eSpark-Backup/oliverstanton-watermonitor/Design-Files/GTV3.5_Board/Deliverables/Renderings/Isometric.png

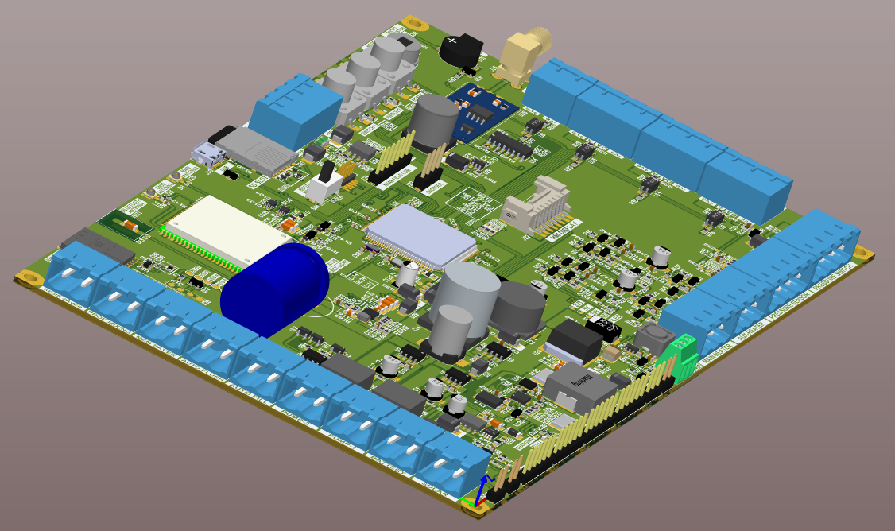
Design-Files/GTV3.5_Board/Deliverables/Renderings/Isometric.png
