eSpark-Backup/oliverstanton-watermonitor/README.md

# OliverStanton-WaterMonitor
To reverse engineer the existing product of the client and generate all the deliverables

 ## Firmware Upload Document
[GrippaT-FirmwareUpload](https://docs.google.com/document/d/1irUmZNVhjHcHC-Ms7zZixrjyYP5oRqWBCGlWPWXGvVM/edit#heading=h.wwlx76fb44li)
