eSpark-Backup/oliverstanton-watermonitor/Design-Files/GTV3.5_Board/GTV3.5_Board.html

Reporting Options

# File in Newer Format

Date | : | 05/03/2024
Time | : | 18:57:56
Project name | : | D:\Github\OliverStanton-WaterMonitor\Design-Files\GTV3.4_Board\GTV3.4_Board.PrjPcb
Schematic documents | : | SD-Card-Sheet.SchDoc

Version | Warning
22.3.0 | Custom diff pair suffixes are not supported in this version.

These files were generated in a later version of Altium Designer. Be aware that some data may have been added through functionality not available in your current version and will therefore not be available to you.
