eSpark-Backup/oliverstanton-watermonitor/Documents/Client-Files/S3 User Instructions/@1 S3 Overview - Description V1.0 .pdf

S3 Pump Controller | Overview | S3

Thank you for buying an S3 Static RO Controller. This is an advanced pump controller solution for your system and it should give you complete control over your water production. Follow this manual carefully. It explains in detail how to connect and operate this pump controller. Most connections are shown on the System Diagram, however further details
are provided throughout the rest of this manual. Complete ALL wiring connections BEFORE connecting the unit to the mains supply. Ensure the controller, sensors and cables are firmly fixed in place before using your controller.
The controller controls the filling side of your water tank (inlet and pure water production). The controller has a number of other advanced features to increase ease of use and report on the operational status of your system.
The controller opens the solenoid valve to fill the water tank up to the level of the high level float switch. This is a one time operation until the tank is full. The controller will automatically flush your RO membrane on a regular basis to keep it at optimum performance and to increase its service life.
The controller can be configured to stop filling if the TDS is too high, either after the RO membrane (due to an RO failure) or after the DI vessel (if resin is spent). It will also shutdown the fill if the mains water pressure is too low.
The controller has a flowmeter to measure the amount of water used and so can also indicate the filter life.
The controller also incorporates a pressure sensor which allows the controller to report on the state of your carbon and sediment filters. The addition of a pressure sensor also allows the controller to shut down your pump in the event of a mains water failure.

### Overview

1
