eSpark-Backup/oliverstanton-watermonitor/Documents/Client-Files/V3 User Instructions/@1 V3 Overview - Description V1.0 .pdf

V3 Pump Controller | Overview | V3

Thank you for buying a V3 Pump Controller. This is an advanced pump controller solution for your system and it should give you complete control over both the water production and water delivery.
Follow this manual carefully. It explains in detail how to connect and operate this pump controller. Most connections are shown on the System Diagram, however further details are provided throughout the rest of this manual. Complete ALL wiring connections BEFORE fitting the main fuse. Ensure the controller, sensors and cables are firmly fixed in place before using your controller.
NOTE: It is recommended that power wires from battery to controller (RED + BLACK)
and power wires to the pump (BROWN + BLUE) are run through flexible conduit.
The controller controls both the filling side of your water tank (inlet and pure water production) and the delivery side (outlet to the reel and pole). The controller also has a number of other advanced features.
The controller opens the solenoid valve to fill the water tank up to the level of the high level float switch. This a one time operation until the tank is full. The controller will automatically flush your RO membrane on a regular basis to keep it at optimum performance and to increase its service life.
The controller can be configured to stop filling if the TDS is too high, either after the RO membrane (due to an RO failure) or after the DI vessel (if resin is spent). It will also shutdown the fill if the mains water pressure is too low.
The controller has a flowmeter to measure the amount of water used and so can also indicate the filter life.
On the delivery side the controller can control the pump flowrate. (It can also be calibrated to shutdown when the pump flow encounters a dead end or stop).
The controller has a built in split charger which will charge your leisure battery as soon as the vehicle alternator starts.
The controller can also control a diesel heater (such as a Webasto) if a hot water system is fitted. The controller allows the heater to be turned on and off. It provides a frost stat (which can be disabled in summer) and also allows the user to set the frost stat activation temperature and the rate of water recirculation.
Finally the controller can be operated by radio control. With the radio fob the user can turn the pump on or off. They can also adjust the flowrate with the up or down button.

### Overview

1
