eSpark-Backup/oliverstanton-watermonitor/Design-Files/Fob_TransmitterV2.00/Deliverables/Renderings/3D_Bottom_View.PNG

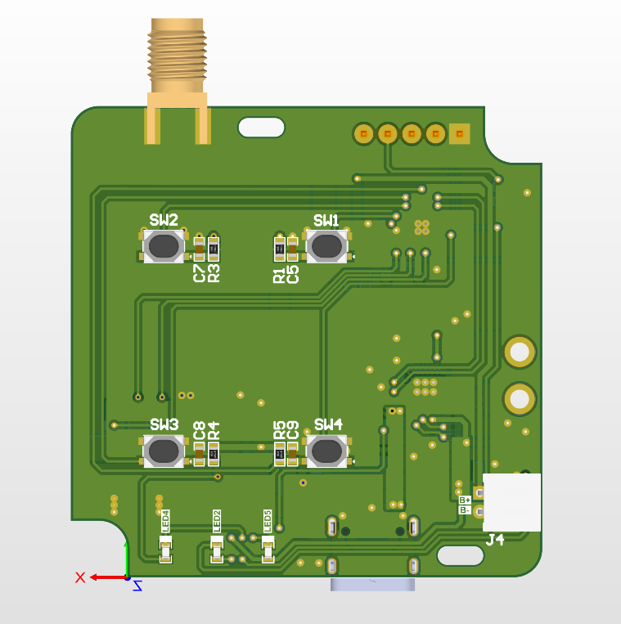
Design-Files/Fob_TransmitterV2.00/Deliverables/Renderings/3D_Bottom_View.PNG
