eSpark-Backup/oliverstanton-watermonitor/Documents/Developer-Files/Parts List.xlsx

Oliver Stanton - Parts List
S.No | Component Type | Component Name | Manufacturer Part Number | Supplier Link | Remarks
1 | IC | Main Controller | STM32F072R8T6 | LCSC (https://www.lcsc.com/product-detail/ST-Microelectronics_STMicroelectronics-STM32F072RBT6_C46046.html)
2
3
4
