eSpark-Backup/oliverstanton-watermonitor/Design-Files/GTV3.5_Board/BOM/Client-BOM-GTV3.4_Board.xlsx

# | Item Type | Designator | Description | Footprint | Manufacturer Part Number | Manufacturer | Value | Quantity | Remarks
1 | Antenna | ANT1 | 5.05dBi Chip antenna Linear 160MHz 2.45GHz 1W 1206 Antennas ROHS | Custom | ANT3216LL00R2400A | YAGEO | - | 1
2 | Capacitor | C1, C4, C17, C21, C23, C24, C43, C58, C61, C63, C65, C67 | CAP ALUM 10uF 25V SMD | Custom | RVT1E100M0405 | ROQANG | 10uF | 12
3 | Capacitor | C2 | CAP CER 0.1UF 100V X7R 1206 | Cap-1206 | CC1206KKX7R0BB104 | Yageo | 0.1uF | 1
4 | Capacitor | C3, C40, C45, C59 | CAP CER 1UF 25V X5R 0603 | Cap0603 | CC0603KRX5R8BB105 | Yageo | 1uF | 4
5 | Capacitor | C5, C88, C90, C97, C102 | CAP CER 0.1UF 100V X5R 0402 | Cap-0402 | GRM155R62A104KE14D | Murata | 0.1uf | 5
6 | Capacitor | C6, C18, C22, C25, C26, C37, C38, C39, C44, C46, C47, C48, C49, C51, C52, C55, C60, C62, C64, C66, C68, C69, C76, C82, C87 | CAP CER 0.1UF 50V Y5V 0603 | Cap0603 | CC0603ZRY5V9BB104 | Yageo | 0.1uF | 25
7 | Capacitor | C7, C15, C71 | CAP CER 1UF 16V X5R 0402 | Cap-0402 | CC0402KRX5R7BB105 | Yageo | 1uF | 3
8 | Capacitor | C8, C28 | CAP CER, X5R, 10 V, 1206 [3216 Metric] | Cap-1206 | C3216X5R1A107M160AC | TDK | 100uF | 2
9 | Capacitor | C9 | CAP ALUM 100UF 20% 25V SMD | Custom | UWX1E101MCL1GB | Nichicon | 100uF | 1
10 | Capacitor | C10, C27, C101, C103, C104, C108 | CAP CER 0.1UF 25V X6S 0201 | CAP-0201 | GRM033C81E104KE14D | Murata | 0.1uF | 6
11 | Capacitor | C11, C19 | CAP CER 1000PF 25V C0G 0402 | Cap-0402 | C1005C0G1E102JT000F | TDK | 1nF | 2
12 | Capacitor | C12, C29, C30, C31, C32, C33, C36, C73, C92, C93, C95, C109, C110, C111, C113, C114 | CAP CER 0.1UF 50V X5R 0402 | Cap-0402 | C1005X5R1H104K050BB | TDK | 0.1uF | 16
13 | Capacitor | C13 | CAP CER 10PF 50V C0G/NP0 0402 | Cap-0402 | GRM1555C1H100JA01D | Murata | 10pF | 1
14 | Capacitor | C14, C96 | CAP CER 33PF 25V C0G/NP0 0402 | Cap-0402 | GRM1555C1E330JA01D | Murata | 33pF | 2
15 | Capacitor | C16 | 470uF ±20% 50V 12.5mm 13.5mm 1000hrs 105℃ -40℃~+105℃ SMD,12.5x13.5mm Aluminum Electrolytic Capacitors - SMD RoHS | Custom | VT1H471MI135000CE0 | Changzhou Huawei Elec | 470uF | 1
16 | Capacitor | C20 | CAP CER 470pF 10% X7R 50V 0603 SMD | Cap0603 | CC0603KRX7R9BB471 | Yageo | 470pF | 1
17 | Capacitor | C34, C35 | CAP 30pF NP0 0603 50 V ±5 % SMD | Cap0603 | CC0603JRNPO9BN300 | Yageo | 30pF | 2
18 | Capacitor | C41, C80, C81, C83, C86 | CAP CER 1UF 50V X5R 0402 | Cap0402 | UMK105CBJ105MV-F | Taiyo Yuden | 1uF | 5
19 | Capacitor | C42, C79, C117 | CAP CER 1UF 25V X5R 0603 | Cap-0603 | CC0603KRX5R8BB105 | Yageo | 1uF | 3
20 | Capacitor | C50, C54, C74 | CAP CER 0.1UF 16V X5R 0402 | Cap-0402 | CC0402KRX5R7BB104 | Yageo | 100nF | 3
21 | Capacitor | C53, C78 | CAP CER 20PF 50V C0G/NPO 0603 | Cap0603 | CC0603JRNPO9BN200 | Yageo | 20pF | 2
22 | Capacitor | C56 | CAP CER 0.047UF 100V X7R 1206 | Cap-1206 | CC1206JRX7R0BB473 | Yageo | 0.047uF | 1
23 | Capacitor | C57 | CAP CER 10UF 35V X5R 0603 | Cap0603 | GRM188R6YA106MA73D | Murata | 10uF | 1
24 | Capacitor | C70 | CAP ALUM 1000UF 20% 10V SMD | Custom | UUD1A102MNL1GS | Nichicon | 1000uF | 1
25 | Capacitor | C72 | CAP CER 10UF 16V X5R 0603 | Cap-0603 | CC0603KRX5R7BB106 | Yageo | 10uF | 1
26 | Capacitor | C75 | CAP CER 0.1UF 50V X7R 0402 | Cap-0402 | CL05B104KB54PNC | Samsung | 0.1uF | 1
27 | Capacitor | C77 | CAP CER 10UF 25V X5R 0603 | Cap-0603 | C1608X5R1E106M080AC | TDK | 10uF | 1
28 | Capacitor | C84, C85, C116, C118, C119 | CAP CER 22UF 35V X5R 0805 | Cap-0805 | C2012X5R1V226MT000E | TDK Corporation | 22uF | 5
29 | Capacitor | C89 | CAP TANT 330UF 20% 16V 2917 | Case-E | TAJE337M016RNJ | Kyocera AVX | 330uF | 1
30 | Capacitor | C91 | CAP TANT 100UF 20% 10V 1411 | Case-B | TAJB107M010RNJ | Kyocera AVX | 100uF | 1
31 | Capacitor | C94 | CAP CER 2.2UF 25V X5R 0402 | Cap-0402 | GRM155R61E225KE11D | Murata | 2.2uf | 1
32 | Capacitor | C98, C99, C100 | CAP CER 22PF 50V C0G/NP0 0201 | CAP-0201 | GRM0335C1H220JA01D | Murata | 22pF | 3
33 | Capacitor | C105, C106 | CAP CER 0.1UF 25V X6S 0201 | CAP-0201 | GRM033C81E104KE14D | Murata | 0.1uF | 2
34 | Capacitor | C107, C112 | CAP CER 10UF 10V X5R 0402 | Cap-0402 | CC0402MRX5R6BB106 | Yageo | 10uF | 2
35 | Supercapacitor | C115 | CAP 25F -10% +30% 2.7V T/H | Custom | SCCU25B256SRB | Kyocera AVX | 25F | 1
36 | Capacitor | C120, C121 | CAP CER 47UF 25V X5R 1206 | Cap-1206 | C3216X5R1E476M160AC | TDK | 47uF | 2
37 | Capacitor | C122 | CAP CER 0.47UF 50V X5R 0603 | Cap-0603 | CC0603KRX5R9BB474 | Yageo | 0.47uF | 1
38 | Capacitor | C123 | CAP CER 2200PF 50V X7R 0603 | Cap-0603 | CC0603KRX7R9BB222 | Yageo | 2.2nF | 1
39 | Capacitor | C124, C126 | CAP ALUM 10uF 25V SMD | Custom | RVT1E100M0405 | ROQANG | 10uF | 2
40 | Capacitor | C125, C127 | CAP CER 0.1UF 50V Y5V 0603 | Cap-0603 | CC0603ZRY5V9BB104 | Yageo | 0.1uF | 2
41 | Capacitor | C128, C129 | CAP CER 22UF 10V X5R 0603 | Cap-0603 | CC0603MRX5R6BB226 | Yageo | 22uF | 2
42 | Diode | D1, D28, D29 | 40V 500mV@2A 2A SMA(DO-214AC) Schottky Barrier Diodes (SBD) ROHS | SMA | SS24A | Yangzhou, Guangdong Hottech | - | 3
43 | Zener diode | D2, D30 | DIODE ZENER 16V 1.5W SMA | SMA | 1SMA5930BT3G | ON Semiconductor, onsemi | - | 2
44 | Diode | D3 | 800uA 43.5A 9.2V 6.4V 5V 7V Bi-Directional SMA TVS ROHS | Custom | SMAJ5.0CA | Shandong Jingdao Microelectronics | - | 1
45 | Diode | D4, D18 | 16A 20V 7V 5V@Max Unidirectional SOT-23 TVS ROHS | Sot-23 | ESD5302F-3/TR | WILLSEMI | - | 2
46 | Diode | D5, D8 | SMB(DO-214AA) TVS ROHS | SMB_ | SMBJ26CA | MSKSEMI | - | 2
47 | Diode | D6 | 1uA 5.3A 113V 77.8V 70V 86V Unidirectional SMB(DO-214AA) TVS ROHS | SMB | SMBJ70A/TR13 | Brightking | - | 1
48 | Diode | D7 | SCHOTTKY DIODE SMB 100V 5A | SS510B | SS510B | MDD | - | 1
49 | ESD Diode | D9, D13 | 0402 ESD Protection Devices ROHS | Custom | TPESD0402G03V | TECH PUBLIC | - | 2
50 | Protection Device | D10, D16, D19 | SOD-523 ESD Protection Devices ROHS | SOD-523 | LESD5D5.0CT1G | UMW | - | 3
51 | Diode | D11 | DIODE SCHOTTKY 60V 5A SMA | SMA | SS56 | MDD | - | 1
52 | Diode | D12 | TVS DIODE 5VWM 9.2VC SMA | SMA | SMAJ5.0CA | FTR | - | 1
53 | Diode | D14 | DIODE SCHOTTKY 40V 10A POWERDI5 | PowerDI™ 5 | PDS1040-13 | Diodes | - | 1
54 | Diode | D15 | DIODE SCHOTTKY 40V 380MA SOD523 | SOD-523 | ZLLS350TA | Diodes Zetex | - | 1
55 | Diode | D17 | TVS DIODE 5VWM 6.3VC DSN0603-2 | DSN0603-2 | PESD5V0H1BSFYL | Nexperia | - | 1
56 | Protection Device | D20, D21, D22, D23, D24 | 5V 10V 3.3V Bi-Directional SOD-882 ESD Protection Devices ROHS | SOD-882 | LESD8D3.3CAT5G | LRC | - | 5
57 | Diode | D25, D26 | DIODE GEN PURP 100V 300MA SOD123 | SOD-123 | 1N4148W-7-F | Diodes | - | 2
58 | Diode | D27 | 35A@8/20us 15V 4.5V@Max Unidirectional DFN1006 TVS ROHS | DFN1006-2L_ | ESD5651N-2/TR | WILLSEMI(Will Semicon) | - | 1
59 | Diode | D31 | 1A Single 1kV 1.1V@1A SMA(DO-214AC) Diodes - General Purpose ROHS | SMA(DO-214AC) | 1N4007 | TWGMC | - | 1
60 | Fuse | F1 | 6V 500mA 40A 1A 0603 Resettable Fuses ROHS | Fuse-0603 | SMD0603-050 | TECHFUSE | - | 1
61 | Fuse | F2, F3 | 9V 200mA 100A 500mA 0805 Resettable Fuses ROHS | Fuse-0805 | SMD0805P020TF | RUILON | - | 2
62 | Ferrite Bead | FB1 | FERRITE BEAD 220 OHM 0805 1LN | Ind-0805 | MPZ2012S221ATD25 | TDK | 100MHz | 1
63 | Jtag Header | J1 | CONN HEADER SMD 10POS 1.27MM | Custom | 20021121-00010C4LF | Amphenol FCI | - | 1
64 | Terminal Block | J2, J3, J4, J5, J6, J7, J8, J9, J11, J21 | TERMINAL BLOCK, PLUGGABLE, 5.08, | Custom | TBP01R1-508-02BE | CUI Devices | - | 10
65 | Terminal Block | J10, J12, J13, J16, J17 | TERMINAL BLOCK, PLUGGABLE, 5.08, | Custom | TBP01R1-508-03BE | CUI Devices | - | 5
66 | Terminal Block | J14, J20, J29 | TERMINAL BLOCK, PLUGGABLE, 5.08, | Custom | TBP01R1-508-04BE | CUI Devices | - | 3
67 | SMA | J15 | 1 Inner bore SMA Board Edge Bend -55℃~+155℃ 50Ω Plugin RF Connectors / Coaxial Connectors ROHS | Custom | HJ-SMA508 | HJ Tech | - | 1
68 | Terminal | J18 | 1x3P -40℃~+105℃ 8A 130V 18~26 Direct Insert 2.54mm 0.5~1 1 3 Plugin,P=2.54mm Screw Terminal Blocks ROHS | Custom | DB125-2.54-3P-GN-S | DORABO | - | 1
69 | USB Connector | J19 | CONN RCPT USB2.0 MICRO B SMD R/A | Custom | 10118194-0001LF | Amphenol FCI | - | 1
70 | Wire To Wire Connector | J22 | 1x8P PH 1 2mm 8 Brass SMD,P=2mm Wire To Board / Wire To Wire Connector ROHS | Custom | A2008WR-S-8P | CJT | - | 1
71 | Header | J23 | Straight 2.54mm Black Brass 1x4P Plugin,P=2.54mm Pin Headers ROHS | HDR1X4_ | B-2100S04P-A110 | Ckmtw | - | 1
72 | Male Header | J24 | Straight Square Pins 2.5mm 7P 6mm -40℃~+105℃ 3mm 2.54mm Plugin Black Brass 1x7P Plugin,P=2.54mm Pin Headers ROHS | HDR1X7 | PZ254V-11-07P | XFCN | - | 1
73 | Connector | J25, J26 | CONN U.FL RCPT STR 50 OHM SMD | Custom | U.FL-R-SMT-1(80) | Hirose | - | 2
74 | SIM Card Connectors | J27 | Copper Alloy Self bomb Gold plating 1.25mm Deck -40℃~+85℃ 260℃ NanoSIM SMD SIM Card Connectors ROHS | Custom | XKNANO-113 | XKB Connectivity | - | 1
75 | Pogo Connector | J28 | Pogo Pad 2.5mm 4 Pin | Custom | POGO Connector 4 Pin | - | - | 1
76 | SD Card Connector | J30 | CONN MICRO SD CARD PUSH-PUSH R/A | Custom | DM3BT-DSF-PEJS | Hirose | - | 1
77 | Inductor | L1 | IND SMD 10uH 500mA 0805 | Ind-0805 | MGFL2012F100MT-LF | microgate | 10uH | 1
78 | Inductor | L2 | Inductor Power Shielded Wirewound 220uH 20% 1KHz Ferrite 1.3A 310mOhm DCR Blister T/R | Custom | SLF12575T-221M1R3-PF | TDK | 220uH | 1
79 | Inductor | L3 | 3.7A 4.7uH ±20% SMD,7.3x7.3mm Power Inductors ROHS | Custom | YPRH0704-4R7M | YJYCOIN | 4.7uH | 1
80 | Inductor | L5 | IND SMD 3.3UH 20A | Custom | SRP1245CC-3R3M | Bourns | 3.3uH | 1
81 | Inductor | L6 | Ind Chip Wirewound 68nH 5% 200MHz 37Q-Factor Ceramic 600mA 0603 | IND-0603 (1608 Metric) | 0603CS-68NXJLW | Coilcraft | 68nH | 1
82 | Inductor | L7 | FIXED IND 470NH 4.9A 0.023OHM SM | Inductor 1008 | DFE252012F-R47M=P2 | Murata | 470nH | 1
83 | LED | LED1, LED2, LED3, LED4, LED5, LED6, LED7 | LED RED CLEAR CHIP SMD | LED 0402 | XZMDK68W-2 | SunLED | - | 7
84 | LED | LED8 | SENSOR PHOTO 630NM 2SMD | Custom | ALS-PT19-315C/L177/TR8 | Everlight | - | 1
85 | LED | LED9 | RED LED 0603 Light Emitting Diodes | LED-0603 | NCD0603R3 | Foshan NationStar Optoelectronics | - | 1
86 | LED | LED10 | Green 520~535nm 0402 Light Emitting Diodes (LED) RoHS | LED-0402 | 16-213/GHC-YR1S1/3T | Everlight Elec | - | 1
87 | LED | LED11, LED13 | Red 632nm LED Indication - Discrete 2.05V 0603 (1608 Metric) | LED-0603 | 19-21/R7C-AK1L2BY/3T | Everlight Elec | - | 2
88 | LED | LED12 | Yellow-Green 572nm LED Indication - Discrete 2.05V 0603 (1608 Metric) | LED-0603 | 19-21/G6C-FM1N2B/3T | Everlight Elec | - | 1
89 | Buzzer | LS1 | NO 2700Hz 85dB @ 3V, 10cm 3V Φ9mm SMD,9x3.2mm Buzzers RoHS | Custom | YS-SBZ9032C03R16 | Fengming | - | 1
90 | Test Point | ~~P1, P7, P9, P10, P11, P16~~ | ~~Test Point ON~~ | ~~Custom~~ | ~~Test-point - 0.5mm~~ | ~~-~~ | ~~-~~ | ~~6~~ | ~~Do NOT PLACE~~
91 | TEST POINT | ~~P2, P12, P13, P14, P15~~ | ~~Test Point ON~~ | ~~Custom~~ | ~~TEST POINT~~ | ~~-~~ | ~~-~~ | ~~5~~ | ~~Do NOT PLACE~~
92 | Connector | P3, P4, P5, P8 | CONN HEADER VERT 6POS 2.54MM | HDR1X6 | 61300611121 | Wurth Electronics | - | 4
93 | Connector | P6 | CONN HEADER VERT 3POS 2.54MM | HDR1X3 | 61300311121 | Wurth Electronics | - | 1
94 | Connector | P19, P27, P28 | CONN HEADER VERT 2POS 2.54MM | HDR1X2 | 61300211121 | Wurth Electronics | - | 3
95 | Mosfet | Q1, Q2, Q3, Q4, Q8 | Single N-Channel, 20V, 4.7A, Power MOSFET | sot-23 | WNM2016A-3/TR | WILLSEMI | - | 5
96 | Mosfet | Q5, Q6 | MOSFET N-CH 55V 110A D2PAK | D2Pak. | IRF3205STRLPBF | Infineon Technologies | - | 2
97 | Mosfet | Q7, Q21 | MOSFET P-CH 20V 3.7A SOT23 | SOT-23 | IRLML6402TRPBF | International Rectifier | - | 2
98 | Transistor | Q9, Q10, Q11, Q12, Q13, Q14, Q15, Q16, Q29, Q30 | NPN Ic=100mA Vceo=45V hfe=200~450 P=250mW | SOT-23 | BC847B,215 | Nexperia | - | 10
99 | Transistor | Q17, Q24 | PNP Ic=-100mA Vceo=-45V hfe=420~800 P=250mW | SOT-23 | BC857C,215 | Nexperia | - | 2
100 | Transistor | Q18, Q19, Q31, Q38 | TRANS NPN 160V 0.6A SOT-23 | SOT-23 | MMBT5551LT1G | ON Semiconductor | - | 4
101 | Mosfet | Q20 | 60V 80A 2.5W 7mΩ@10V,20A 3V@250μA N Channel SOP-8_150mil MOSFETs ROHS | Custom | RU6085H | Shenzhen | - | 1
102 | Mosfet | Q22, Q23, Q33, Q40, Q43 | TRANS NPN 40V 0.6A SMD SOT23-3 | SOT-23 | MMBT2222A-7-F | Diodes | - | 5
103 | Mosfet | Q25 | MOSFET N-CH 130V 1A SOT23 | SOT23-3 | DMN13H750S-7 | Diodes | - | 1
104 | Mosfet | Q26 | N-CHANNEL 20-V (D-S) MOSFET | Sot-23 | SI2302CDS | TECH PUBLIC | - | 1
105 | Mosfet | Q32 | 30V 4.1A 60mΩ@10V,4.1A 350mW 3V@250uA P Channel SOT-23 MOSFETs ROHS | SOT-23 | AO3407 | Guangdong Hottech | - | 1
106 | Mosfet | Q39 | MOSFET N-CH 60V 115MA SOT23-3 | SOT23-3 | 2N7002-7-F | Diodes | - | 1
107 | Resistor | R1 | Res Thick Film 0603 3.6K Ohm 1% 1/10W ±100ppm/°C Molded SMD Paper T/R | RES-0603 | AC0603FR-073K6L | Yageo | 3.6K | 1
108 | Resistor | R2 | RES 1.2K OHM 1% 1/10W 0603 | RES-0603 | RC0603FR-071K2L | Yageo | 1.2k | 1
109 | Resistor | R3 | ±1% 1/10W Thick Film Resistors 75V ±600ppm/℃ -55℃~+155℃ 0.33Ω 0603 Chip Resistor - Surface Mount ROHS | RES-0603 | RTT03R330FTP | RALEC | 0.33R | 1
110 | Resistor | R4, R6, R9, R27, R68, R69, R70, R72, R82, R101, R102, R110, R114, R126, R128, R168 | RES SMD 10K Ohm 1% 1/10W 0603 | Res-0603 | RC0603FR-0710KL | Yageo | 10K | 16
111 | Resistor | R5, R8 | RES SMD 4.7K OHM 0.1% 1/10W 0603 | Res-0603 | AT0603BRD074K7L | Yageo | 4.7K | 2
112 | Resistor | R7, R10 | RES SMD 6.8K OHM 0.1% 1/10W 0603 | Res-0603 | RT0603BRE076K8L | Yageo | 6.8K | 2
113 | Resistor | R11 | 100mW Thick Film Resistors 75V ±1% ±100ppm/℃ -55℃~+155℃ 2.21MΩ 0603 Chip Resistor - Surface Mount ROHS | RES-0603 | 0603WAF2214T5E | UNI-ROYAL | 2.21M | 1
114 | Resistor | R12, R73, R74, R134, R170 | RES 10K OHM 1% 1/16W 0402 | Res-0402 | RC0402FR-0710KL | Yageo | 10K | 5
115 | Resistor | R13 | RES 2.7K OHM 1% 1/16W 0402 | Res-0402 | RC0402FR-072K7L | Yageo | 2.7K | 1
116 | Resistor | R14, R15, R17 | RES SMD 680 OHM 1% 1/10W 0603 | RES-0603 | RC0603FR-07680RL | Yageo | 680R | 3
117 | Resistor | R16 | RES SMD 2.2K OHM 1% 1/16W 0402 | Res-0402 | RC0402FR-072K2L | Yageo | 2.2K | 1
118 | Resistor | R18, R19, R22, R37, R39, R78, R80, R111, R115 | RES SMD 2.2K OHM 1% 1/10W 0603, RES 2.2K OHM 1% 1/10W 0603 | RES-0603 | RC0603FR-072K2L | Yageo Phycomp, Yageo | 2.2K | 9
119 | Resistor | R20, R21, R66 | RES SMD 10K OHM 5% 1/10W 0603 | RES-0603 | AC0603JR-0710KL | Yageo | 10K | 3
120 | Resistor | R23, R35, R36, R38, R76, R77, R79 | RES SMD 3.3K OHM 1% 1/10W 0603 | RES-0603 | RC0603FR-073K3L | Yageo Phycomp | 3.3K | 7
121 | Resistor | R24, R25 | RES SMD 47OHM 0.1W 0603 | RES-0603 | RC0603FR-0747RL | Yageo | 47R | 2
122 | Resistor | R26, R34, R40, R41, R50, R51, R67, R71, R75, R85 | RES SMD 1K OHM 1% 1/10W 0603 | RES-0603 | RC0603FR-071KL | Yageo | 1K | 10
123 | Resistor | R28, R33, R42, R43, R44, R45, R46, R47, R48, R49, R52, R53, R56, R62, R86, R88 | RES SMD 4.7K OHM 1% 1/10W 0603 | RES-0603 | RC0603FR-074K7L | Yageo | 4.7K | 16
124 | Resistor | R29, R107 | RES SMD 1K 0.1W 0603 75 V, Thick Film | Res-0603 | RC0603JR-071KL | Yageo | 1K | 2
125 | Resistor | R30 | RES SMD 20K OHM 0.1% 1/10W 0603 | Res-0603 | RT0603BRD0720KL | Yageo | 20K | 1
126 | Resistor | R31, R57, R58, R59, R60, R61, R106, R138, R141, R146, R154 | RES 4.7K OHM 1% 1/16W 0402 | Res-0402 | RC0402FR-074K7L | Yageo | 4.7K | 11
127 | Resistor | R32 | RES SMD 63.4KOHM 0.1% 1/10W 0603 | Res-0603 | RT0603BRE0763K4L | Yageo | 63.4K | 1
128 | Resistor | R54 | RES SMD 13.7KOHM 0.1% 1/10W 0603 | Res-0603 | AT0603BRD0713K7L | Yageo | 13.7K | 1
129 | Resistor | ~~R55, R104, R105, R169~~ | ~~RES 100K OHM 1% 1/16W 0402~~ | ~~Res-0402~~ | ~~RC0402FR-07100KL~~ | ~~Yageo~~ | ~~DNP~~ | ~~4~~ | ~~Do NOT PLACE~~
130 | Resistor | R63, R87 | RES SMD 22 OHM 1% 1/5W 0402 | Res-0402 | RCS040222R0FKED | Vishay Dale | 22R | 2
131 | Resistor | R64 | RES 100K OHM 1% 1/8W 0805 | RES-0805 | RC0805FR-07100KL | Yageo | 100K | 1
132 | Resistor | R65 | RES 1K OHM 1% 1/2W 1206 | Res-1206 | RC1206FR-7W1KL | Yageo | 1K | 1
133 | Resistor | R81, R131 | RES 470 OHM 1% 1/10W 0603 | Res-0603 | RC0603FR-07470RL | Yageo | 470R | 2
134 | Resistor | R83, R84 | RES SMD 200K OHM 1% 1/10W 0603 | RES-0603 | RC0603FR-07200KL | Yageo | 200K | 2
135 | Resistor | R89, R90, R99, R100 | RES 100K OHM 1% 1/10W 0603 | RES-0603 | RC0603FR-07100KL | Yageo | 100K | 4
136 | Resistor | R91, R92, R161, R162 | Res SMD 0603 1M Ohm 1% 1/10W ±100ppm/°C Molded SMD Paper T/R, RES SMD 1M OHM 1% 1/10W 0603 | RES-0603 | RC0603FR-071ML | Yageo | 1M | 4
137 | Resistor | R93, R94 | RES SMD 330R 100 mW 0603 | Res-0603 | RC0603JR-07330RL | Yageo | 330R | 2
138 | Resistor | R95, R96 | RES SMD 50K ±0.5% ±25ppm/℃ 0805 | RES 0805 | ARG05DTC5002 | Viking Tech | 50K | 2
139 | Resistor | R97, R98 | Res SMD 0603 150K Ohm 1% 0.1W(1/10W) ±100ppm/C Pad SMD T/R | RES-0603 | RC0603FR-07150KL | Yageo | 150K | 2
140 | Resistor | R103 | RES 150 OHM 0.5% 1/10W 0603 | Res-0603 | RC0603DR-07150RL | Yageo | 150R | 1
141 | Resistor | R108 | RES 120 OHM 1% 1/10W 0603 | Res-0603 | RC0603FR-07120RL | Yageo | 120R | 1
142 | Resistor | R109, R136 | RES SMD 1.82M OHM 1% 1/10W 0603 | Res-0603 | CRCW06031M82FKEA | Vishay | 1.82M | 2
143 | Resistor | R112 | RES SMD 7.5K OHM 0.1% 1/10W 0603 | Res-0603 | RT0603BRD077K5L | Yageo | 7.5K | 1
144 | Resistor | R113 | RES 3.3K OHM 0.5% 1/10W 0603 | Res-0603 | RC0603DR-073K3L | Yageo | 3.3K | 1
145 | Resistor | R116, R163 | RES 20K OHM 1% 1/10W 0603 | Res-0603 | RC0603FR-0720KL | Yageo | 20K | 2
146 | Resistor | R117, R118 | RES 0 OHM JUMPER 1/10W 0603 | Res-0603 | RC0603JR-070RL | Yageo | 0R | 2
147 | Resistor | R119 | RES 10 OHM 1% 1/8W 0805 | RES-0805 | TNPW080510R0FEEA | Vishay | 10R | 1
148 | Resistor | R120 | RES 0.004 OHM 1% 3W 2512 | RES 2512 | PA2512FKE7T0R004E | Yageo | 4mR | 1
149 | Resistor | R121 | RES 2.2 OHM 1% 1/16W 0402 | Res-0402 | RC0402FR-072R2L | Yageo | 2.2R | 1
150 | Resistor | R122 | 100mW 75V 5.23kΩ 0603 | RES-0603 | RTT035231FTP | RALEC | 5.23K | 1
151 | Resistor | R123 | RES 499K OHM 0.1% 1/16W 0402 | Res-0402 | RC0402BR-07499KL | Yageo | 499K | 1
152 | Resistor | R124 | 100mW 75V 30.1kΩ 0603 | RES-0603 | 0603WAF3012T5E | UNI-ROYAL | 30.1K | 1
153 | Resistor | R125 | RES SMD 36K OHM 0.1% 1/16W 0402 | Res-0402 | RT0402BRD0736KL | Yageo | 36K | 1
154 | Resistor | R127 | ±0.1% 100mW Thin Film Resistor 75V 499kΩ 0603 Chip Resistor - Surface Mount ROHS | Res-0603 | TR0603B499KP0525Z | Ever Ohms Tech | 499K | 1
155 | Resistor | R129 | RES SMD 86.6KOHM 0.1% 1/16W 0402 | Res-0402 | RT0402BRD0786K6L | Yageo | 86.6K | 1
156 | Resistor | R130 | RES SMD 100K OHM 5% 1/20W 0201 | Res-0201 | RC0201JR-07100KL | Yageo | 100K | 1
157 | Resistor | R132 | RES 470 OHM 5% 1/20W 0201 | Res-0201 | RC0201JR-07470RL | Yageo | 470R | 1
158 | Resistor | R133, R139, R142, R144, R147, R155 | RES 47K OHM 1% 1/16W 0402 | Res-0402 | RC0402FR-0747KL | Yageo | 47K | 6
159 | Resistor | R135, R140 | RES 1K OHM 1% 1/20W 0201 | Res-0201 | RC0201FR-071KP | Yageo | 1K | 2
160 | Resistor | R137, R145 | RES SMD 220 OHM 1% 1/10W 0603 | Res-0603 | CRCW0603220RFKEA | Vishay Dale | 220R | 2
161 | Resistor | R143 | RES SMD 10 OHM 1% 1/5W 0402 | Res-0402 | CRCW040210R0FKEDHP | Vishay Dale | 10R | 1
162 | Resistor | R148, R149 | 1W Thick Film Resistors ±5% ±800ppm/℃ 0Ω 2512 Chip Resistor - Surface Mount ROHS | RES-2512 | 25121WJ0000T4E | UNI-ROYAL | 0R | 2
163 | Resistor | R150, R151, R152, R153 | RES 22 OHM 1% 1/20W 0201 | Res-0201 | RC0201FR-0722RL | Yageo | 22R | 4
164 | Resistor | R156, R157, R158, R159, R160 | RES SMD 10K OHM 1% 1/20W 0201 | Res-0201 | RC0201FR-0710KL | Yageo | 10K | 5
165 | Resistor | R164 | RES SMD 402K OHM 1% 1/10W 0603 | Res-0603 | CRCW0603402KFKEA | Vishay | 402K | 1
166 | Resistor | R165 | RES 845K OHM 1% 1/10W 0603 | Res-0603 | RC0603FR-07845KL | Yageo | 845K | 1
167 | Resistor | R166 | RES 499K OHM 1% 1/10W 0603 | Res-0603 | RC0603FR-07499KL | Yageo | 499K | 1
168 | Resistor | R167 | RES SMD 33K OHM 5% 1/10W 0603 | Res-0603 | CRCW060333K0JNEA | Vishay Dale | 33K | 1
169 | Solder bridge | ~~SB2, SB3, SB5, SB7, SB8, SB9, SB35, SB36, SB37, SB38, SB39, SB40, SB43, SB44~~ | ~~Solder Bridge ON~~ | ~~Custom~~ | ~~Solder Bridge~~ | ~~-~~ | ~~-~~ | ~~14~~ | ~~Do NOT PLACE~~
170 | Switch | SW1, SW2 | SWITCH TACTILE SPST-NO 0.05A 12V | Custom | TL3300CF160Q | E-Switch | - | 2
171 | Switch | SW3 | SWITCH TACTILE SPST-NO 0.05A 12V | Custom | TL3300CF160Q | E-Switch | - | 1
172 | Switch | SW4 | Straight 1A SPDT 8.7mm 8.6mm 24V 4.5mm Black PCPin 10000 Rectangular columnar -25℃~+70℃ Plugin Slide Switches ROHS | Custom | SS-12D02-G040 | G-Switch | - | 1
173 | IC | U1, U2 | SENSOR CURRENT HALL 20A DC | SOIC-8 | ACS723LLCTR-20AU-T | Allegro MicroSystems | - | 2
174 | IC | U3 | 1.5-A boost, buck, inverting switching regulator, operation from 0°C to 70°C 8-SOIC 0 to 70 | SOIC-8 | MC34063ADR | Texas Instruments | - | 1
175 | IC | U4 | IC REG LINEAR 3.3V 1A SOT223 | SOT-223 | LMS8117AMP-3.3/NOPB | Texas Instruments | - | 1
176 | IC | U5 | IC REG BUCK-BOOST ADJ 3A 16TQFN | 16-QFN (3x3). | MAX38889AATE+ | Analog Devices | - | 1
177 | IC | U6 | IC GATE DRVR LOW-SIDE 8SOIC | SOIC-8 | NCP81071ADR2G | ON Semiconductor | - | 1
178 | IC | U7 | IC OR CTRLR N+1 8MSOP | Custom | LTC4359CMS8#PBF | Analog Devices / Linear Technology | - | 1
179 | IC | U8, U9, U14, U15 | TransistorOptocouplers DC 1 2500Vrms SOP-4_P1.27 Optocouplers RoHS | Custom | PS2801C-1-F3-A | CEL | - | 4
180 | IC | U10, U11, U12 | IC BUF NON-INVERT 5.5V SOT23-5 | SOT-23-5 | SN74LV1T34DBVR | Texas Instruments | - | 3
181 | IC | U13 | SOT-23-6 Comparators ROHS | SOT-23-6 | TPS3700DDCR | Texas Instruments | - | 1
182 | IC | U16 | IC SWITCH SP4T X 2 75OHM 16SOIC | SOIC-16 | SN74LV4052ADR | Texas Instruments | - | 1
183 | IC | U17 | Through Hole Biometric Sensors ROHS | AS312 | AS312 | Senba | - | 1
184 | IC | U18 | 40V 20A 17mΩ@10V,10A 21W 1.6V@250uA 72pF@20V 2 N-Channel 1.05nF@20V 11nC@10V +150℃@(Tj) PDFN3x3 | PDFN3x3 | AP4008QD | ALLPOWER(ShenZhen Quan Li Semiconductor) | - | 1
185 | IC | U19 | IC BATT CHG MULTI-CHEM 16VQFN | QFN-16-EP(3.6x3.6) | BQ24650RVAR | Texas Instruments | - | 1
186 | IC | U20 | IC REG LDO ADJ 3A TO263-5 | TO-263-5 (D2PAK) | MIC29302WU-TR | Microchip | - | 1
187 | IC | U21 | IC MCU 32BIT 1MB FLASH 144LQFP | LQFP-144(20x20) | STM32F103ZGT6 | STM | - | 1
188 | IC | U22 | 15V 5 Unidirectional 5V SOT-363 ESD Protection Devices ROHS | SOT-363 | SMF05CT1G-ES | ElecSuper | - | 1
189 | IC | U23, U26 | IC TRNSLTR BIDIRECTIONAL US8 | Custom | TXB0102DCUT | Texas Instruments | - | 2
190 | IC | U24 | SOP-8 RS-485/RS-422 ICs ROHS | SOP-8 | SP3485EIM/TR | HGSEMI | - | 1
191 | IC | U25 | RF TXRX MODULE CELLULAR SMD | Custom | A7672E (FASE) | SIMCom Wireless Solutions Limited | - | 1
192 | IC | U27 | IC REG LINEAR 3.3V 1A SOT223 | SOT- 223 | LMS8117AMP-3.3/NOPB | Texas Instruments | - | 1
193 | IC | U28 | HC12 Si4463 433MHZ RF Wireless Serial Module | HC-12 Module SMD | HC-12 | - | - | 1
194 | IC | U29 | SOT-23-5 Power Distribution Switches ROHS | SOT-23-5 | SY6280AAC | Silergy | - | 1
195 | IC | U30 | IC REG BUCK 5V 2A TSOT26 | TSOT-23-6 | AP63205WU-7 | Diodes | - | 1
196 | Crystal | X1 | 8MHz SMD Crystal Resonator 18pF 200Ω ±20ppm ±30ppm -40℃~+85℃ SMD3225-4P Crystals ROHS | Custom | XC32M4-8.000-F18LJDT | HCI | 8MHz | 1
197 | Crystal | X3 | 32.768kHz SMD Crystal Resonator 12.5pF ±20ppm -40℃~+85℃ SMD3215-2P Crystals ROHS | Custom | X321532768KGD2SI | Yangxing Tech | 32.768kHz | 1
198 | Peripheral | - | WS2812B Led Lights DC5V WS2812 RGB Led Strip Light (1m 30 IP67) | - | RGB LED Strip | - | - | 1 | Aliexpress (https://www.aliexpress.us/item/2251801850504415.html)
199 | Peripheral | - | 3Pin led Connector Male/female JST SM 2 3 4 5 6Pin Plug Connector Wire Cable for Led Strip Light Lamp Driver | - | Plug Connector (3Pin) | - | - | 10 | Aliexpress (https://www.aliexpress.us/item/3256804429301946.html)
