eSpark-Backup/oliverstanton-watermonitor/Design-Files/Fob_TransmitterV2.00/Deliverables/Supporting Files/Transmitter_PCB-v3.4.step

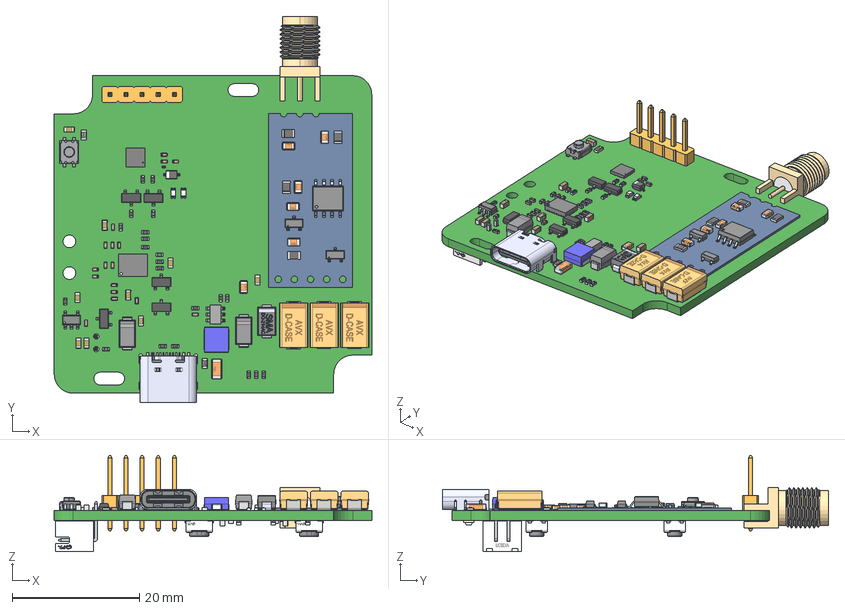
[picture p4: CAD file, 2025-01-28]
Design-Files/Fob_TransmitterV2.00/Deliverables/Supporting Files/Transmitter_PCB-v3.4.step
50.0 x 60.8 x 15.1 mm
CircuitWorks-SOT-23 x 5
PCB1
BQ51013BRHLR--3DModel-STEP-56544
User Library-CAPC1608X09 x 13
User Library-AVX_D_CASE x 3
21-0058I_MXM
User Library-RES_1005-0402 x 21
User Library-RESC1608X05N x 6
User Library-LED SMD0603 x 5
FilletPin1
FilletPin2
TYPE-C-31-M-12
User Library-SOD323-1
SMA (DO-214AC)
User Library-DO-214AC SMA x 2
User Library-Capacitor 0402 x 17
User Library-1206 SMD Capacitor
User Library-0805 SMD Capacitor
User Library-zl201-5_p2-54_l12-7_w2-54_h8-89
VQFN20_3X3_MCH
SN74LV1T34DBVR
ts-1185ec-c-d-b_RGB6710886
Ferrite
