eSpark-Backup/oliverstanton-watermonitor/Design-Files/TDS_Meter/Supporting Files/PCB_TDS-v3.4.DXF

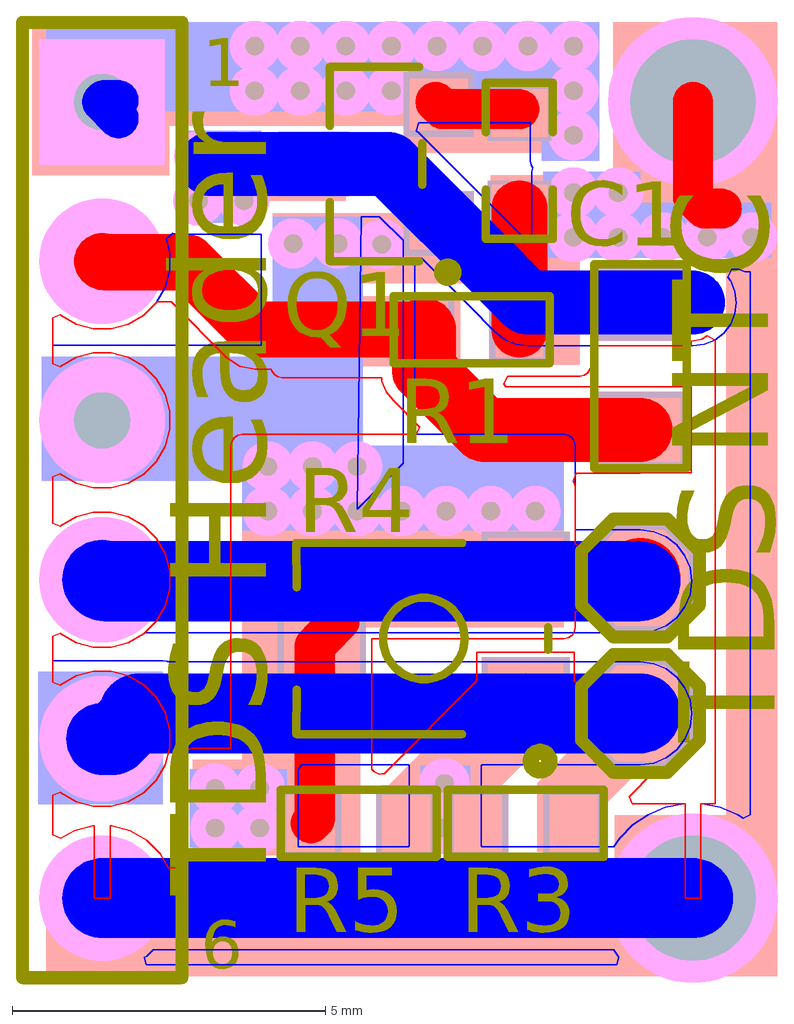
[picture p5: CAD file, 2025-01-16]
Design-Files/TDS_Meter/Supporting Files/PCB_TDS-v3.4.DXF
NTC
TDS
TDS Header
6
1
R4
R5
R3
R1
Q1
C1
