eSpark-Backup/oliverstanton-watermonitor/(list of files, cad)

Other CAD files:
Design-Files/GTV3.5_Board/Deliverables/Supporting_Files/PCB_GTV3.4.DWG
Design-Files/TDS_Meter/Supporting Files/PCB_TDS-v3.4.DWG
