eSpark-Backup/oliverstanton-watermonitor/Documents/Client-Files/S2 User Instructions/S2 .pdf

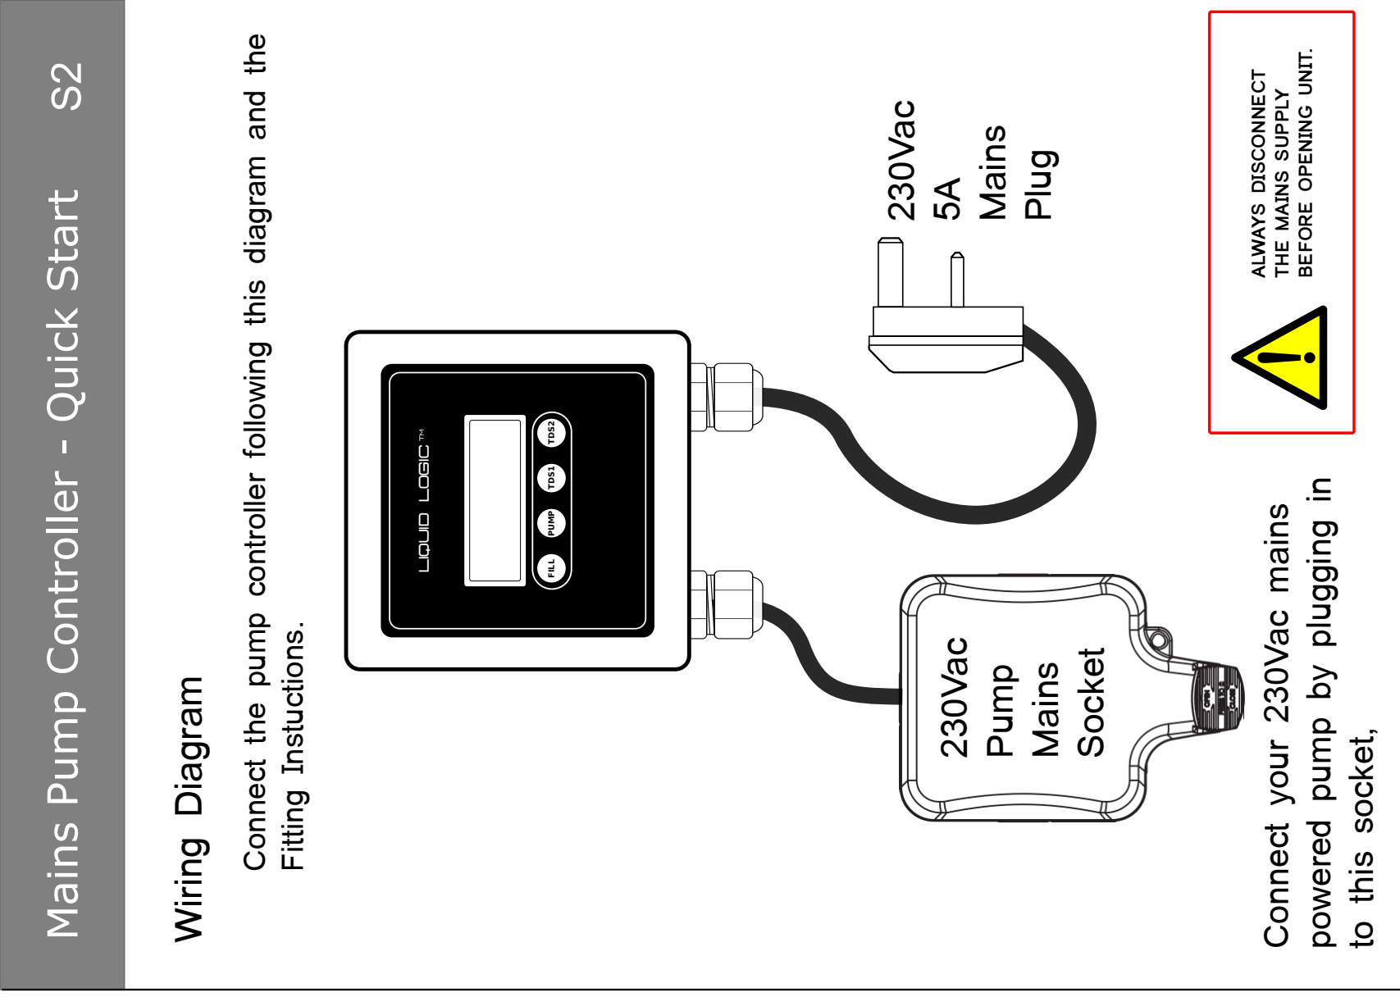
[picture p6: figure]
Fitting Instuctions.; Mains Pump Controller - Quick Start; Wiring Diagram; Connect your 230Vac mains; powered pump by plugging in; to this socket,; ALWAYS DISCONNECT THE MAINS SUPPLY; BEFORE OPENING UNIT. !; 230Vac Pump; Mains; Socket; LIQUID LOGIC; CAL; FILL; DISPLAY MODE; TDS2TDS1 FILL PUMP; 230Vac; Mains Plug

Connect the pump controller following this diagram and the

### Step 1. Fitting Instructions

This S2 unit is supplied already wired. There is no need to
disconnect any wires. Follow these instructions carefully

and refer to the wiring diagram.

IT IS RECOMMENDED THAT YOUR S2 IS FITTED AGAINST A

WALL OR SIMILAR VERTICAL SURFACE.

1. Ensure the S2 is NOT PLUGGED into the MAINS SUPPLY.
2. Remove the top cover by loosening the four corner screws. These
screws are quarter turn. Using a large pozidrive screw driver, push

the screw down and through a quarter turn then release. The screw

should pop up. DO NOT continuously turn.

3. Carefully remove the top cover. Replace any keycaps on the

controller switches carefully.

4. Screw unit to the wall or vertical surface through the four ready

drilled holes in the corners of the back box.

5. Carefully replace the top cover and tighten the four corner
screws quarter turn screws, using the reverse procedure to

instruction 2. above.

You are now ready to control your pump.

NOTE: Only switch on MAINS SUPPLY to the 230Vac 5A Mains Plug

once front cover has been re-fitted.

DISCLAIMER

Unit must be installed by a competent electrician or electrical engineer. Failure

to comply with these instructions could invalidate your warranty.
ALWAYS DISCONNECT THE MAINS SUPPLY

BEFORE OPENING UNIT.

ALWAYS DISCONNECT THE MAINS SUPPLY

# BEFORE CONNECTING THE PUMP !

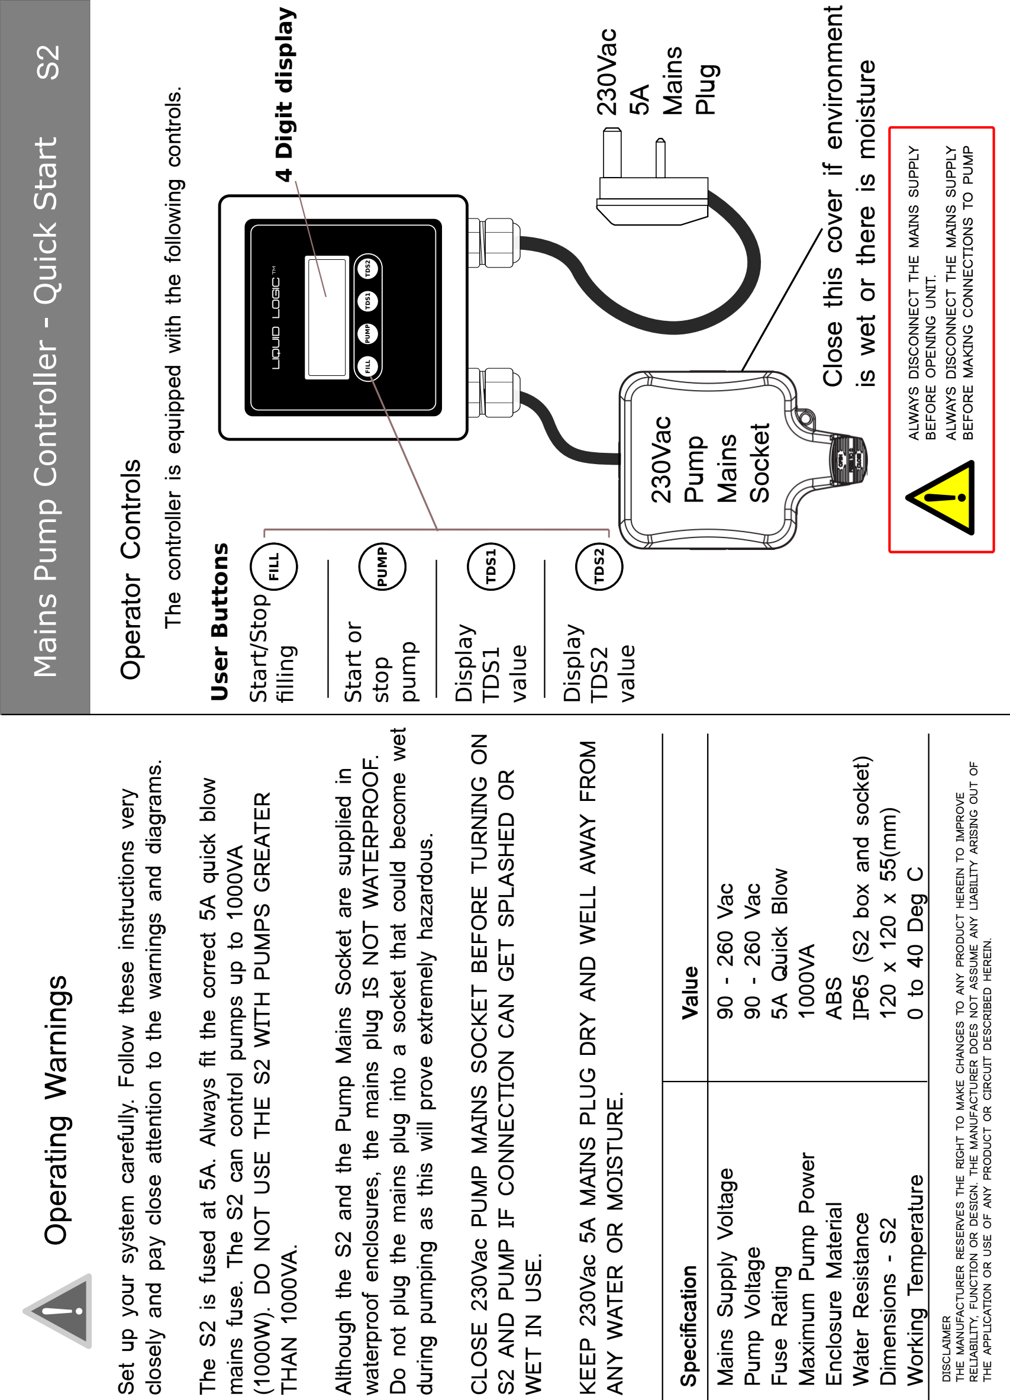
[picture p7: figure]
Mains Pump Controller - Quick Start; Operator Controls; S2 Operating Warnings; THAN 1000VA.; WET IN USE.; ANY WATER OR MOISTURE.; Specification Value; Mains Supply Voltage; Pump Voltage Fuse Rating; Maximum Pump Power Enclosure Material Water Resistance Dimensions - S2; Working Temperature; 90 - 260 Vac; 5A Quick Blow; ABS; IP65 (S2 box and socket) 120 x 120 x 55(mm) 0 to 40 Deg C; DISCLAIMER; ALWAYS DISCONNECT THE MAINS SUPPLY; BEFORE OPENING UNIT.; ALWAYS DISCONNECT THE MAINS SUPPLY BEFORE MAKING CONNECTIONS TO PUMP !; 4 Digit display; 230Vac; Mains Plug; 230Vac Pump; Mains; Socket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

The controller is equipped with the following controls.

Set up your system carefully. Follow these instructions very

closely and pay close attention to the warnings and diagrams.
The S2 is fused at 5A. Always fit the correct 5A quick blow
mains fuse. The S2 can control pumps up to 1000VA

(1000W). DO NOT USE THE S2 WITH PUMPS GREATER

Although the S2 and the Pump Mains Socket are supplied in

waterproof enclosures, the mains plug IS NOT WATERPROOF.

Do not plug the mains plug into a socket that could become wet

during pumping as this will prove extremely hazardous.

CLOSE 230Vac PUMP MAINS SOCKET BEFORE TURNING ON
S2 AND PUMP IF CONNECTION CAN GET SPLASHED OR

KEEP 230Vac 5A MAINS PLUG DRY AND WELL AWAY FROM

THE MANUFACTURER RESERVES THE RIGHT TO MAKE CHANGES TO ANY PRODUCT HEREIN TO IMPROVE

RELIABILITY, FUNCTION OR DESIGN. THE MANUFACTURER DOES NOT ASSUME ANY LIABILITY ARISING OUT OF

THE APPLICATION OR USE OF ANY PRODUCT OR CIRCUIT DESCRIBED HEREIN.

## Tank Filling S2

Wire the solenoid valve and float switch following

this diagram. Use only the wires shown.

### Additional Wiring Set Up - Tank Filling

To start filling the tank simply press the 'FILL'. This will

activate the pump and the solenoid valve, allowing water

to fill the tank, until the float switch detects that the tank

is full.

While the pump and solenoid valve are on and the tank
is filling, the display will flash the message FILL. Whilst
FILL is active the unit will keep filling every time the

level switch drops, hence maintaining the correct level.

LIQUID LOGIC

CAL

FILL

DISPLAY MODE

TM TM

TDS2TDS1 FILL PUMP

To manually stop the tank filling, press the 'FILL' button
again. The display will stop showing the FIL message

and display message STOP.

Solenoid Valve
Level switch

FILL

To manually turn the pump on (over riding the FILL
operation) press the PUMP button. The display will

change to ON.

PUMP

To manually turn the pump off (over riding the FILL
operation) press the PUMP button. The display will

change to OFF.

PUMP
FILL

## TDS S2

Install on

RO outlet

Install on
DI outlet

Fit the TDS probes in John Guest 1/2" equal tee (not

supplied) as shown on the diagram.

### Additional Wiring

The TDS* function provides an indication of the water purity.

The TDS values displayed are in ppm** (impurities in parts per
million). The TDS meter is intended to check pure water and

has a max reading of 50ppm.

We recommend TDS1 probe be fitted after the RO (reverse
osmosis) filter. You can then check the RO is working

correctly.

We recommend TDS2 probe be fitted after the DI (de-ionising)

vessels. You can then check DI vessels are working.

For good cleaning a TDS of below 5ppm after the DI is

recommended.

### Set Up - TDS (Total Dissolved Solids)

LIQUID LOGIC

CAL

FILL

DISPLAY MODE

TM

JG JG

TDS1

Probe

TDS2

Probe

Press TDS1 to monitor TDS1 reading (in ppm).

,

Press TDS2 to monitor TDS2 reading (in ppm).

,

A TDS reading greater than 50ppm will display high.

LIQUID LOGIC TM

TDS2TDS1 FILL PUMP

* Unit must be installed by a competant electrician or technician. Failure to comply with

these instructions could invalidate your warranty.

** Probe must be undamaged, clean and free from dirt. Readings are only accurate to

+/-2.5% of displayed value when dissolved solid is NaCl.

!

Take care when handling TDS probes. Do not

damage gold plated contacts as this will affect

TDS accuracy.

Ensure gold plated contacts are clean before

use. Clean with ISOPROPANOL alcohol (IPA)

and a soft cloth.

Dirty contacts will affect TDS accuracy, clean

with IPA if readings appear to deviate over time. .

TDS1

TDS2
