eSpark-Backup/oliverstanton-watermonitor/Documents/Client-Files/S3 User Instructions/@3 S3 Quick Start - Operator Warnings 1 V1.0 2.pdf

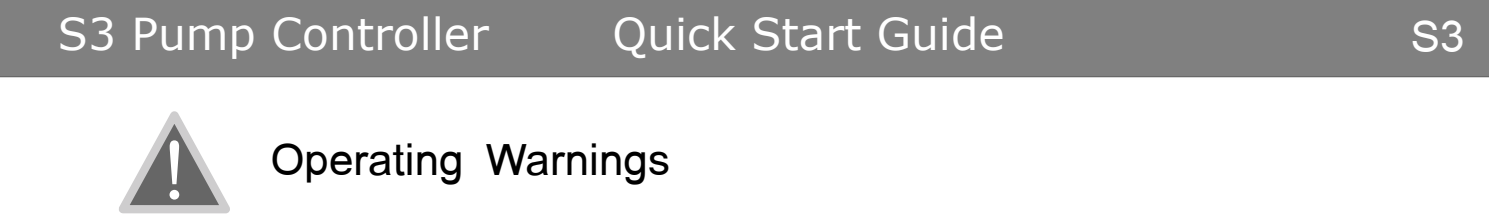
[picture p8: figure]
Operating Warnings; S3 Pump Controller; Quick Start Guide

Set up your system carefully. Follow these instructions very closely and pay close attention to the warnings and diagrams.
The S3 is fused at 5A. Always fit the correct 5A quick blow mains fuse. The S3 can control pumps up to 1000VA (1000W). DO NOT USE THE S3 WITH PUMPS GREATER THAN 1000VA.
Although the S3 and the Pump Mains Socket are supplied in a waterproof enclosure, the mains plug IS NOT WATERPROOF. Do not plug the mains plug into a socket that could become wet during pumping as this will prove extremely hazardous.
CLOSE 230Vac PUMP MAINS SOCKET BEFORE TURNING ON S3 IF CONNECTION --CAN GET SPLASHED OR WET IN USE.
KEEP 230Vac 5A MAINS PLUG DRY AND WELL AWAY FROM ANY WATER OR MOISTURE.

3

The controller is equipped with the following controls.

### Operator Controls

Specification | Value
Mains Supply Voltage Pump Voltage Fuse Rating Maximum Pump Power Enclosure Material Water Resistance Dimensions - S3 Working Temperature | 90 - 260 Vac 90 - 260 Vac 5A Quick Blow 1000VA ABS IP65 240 x 160 x 90mm 0 to 40 Deg C

DISCLAIMER
THE MANUFACTURER RESERVES THE RIGHT TO MAKE CHANGES TO ANY PRODUCT HEREIN TO IMPROVE RELIABILITY, FUNCTION OR DESIGN. THE MANUFACTURER DOES NOT ASSUME ANY LIABILITY ARISING OUT OF THE APPLICATION OR USE OF ANY PRODUCT OR CIRCUIT DESCRIBED HEREIN.

Start/Stop
filling

Increase a value
or go up to next
menu item

F

Decrease a value
or go down to next
menu item

Enter/Set a value
or scroll to next
display item
