eSpark-Backup/oliverstanton-watermonitor/Documents/Client-Files/S3 User Instructions/@4 S3 Quick Start - Operator Warnings 2 V1.0.pdf

S3 Pump Controller | Quick Start Guide | S3

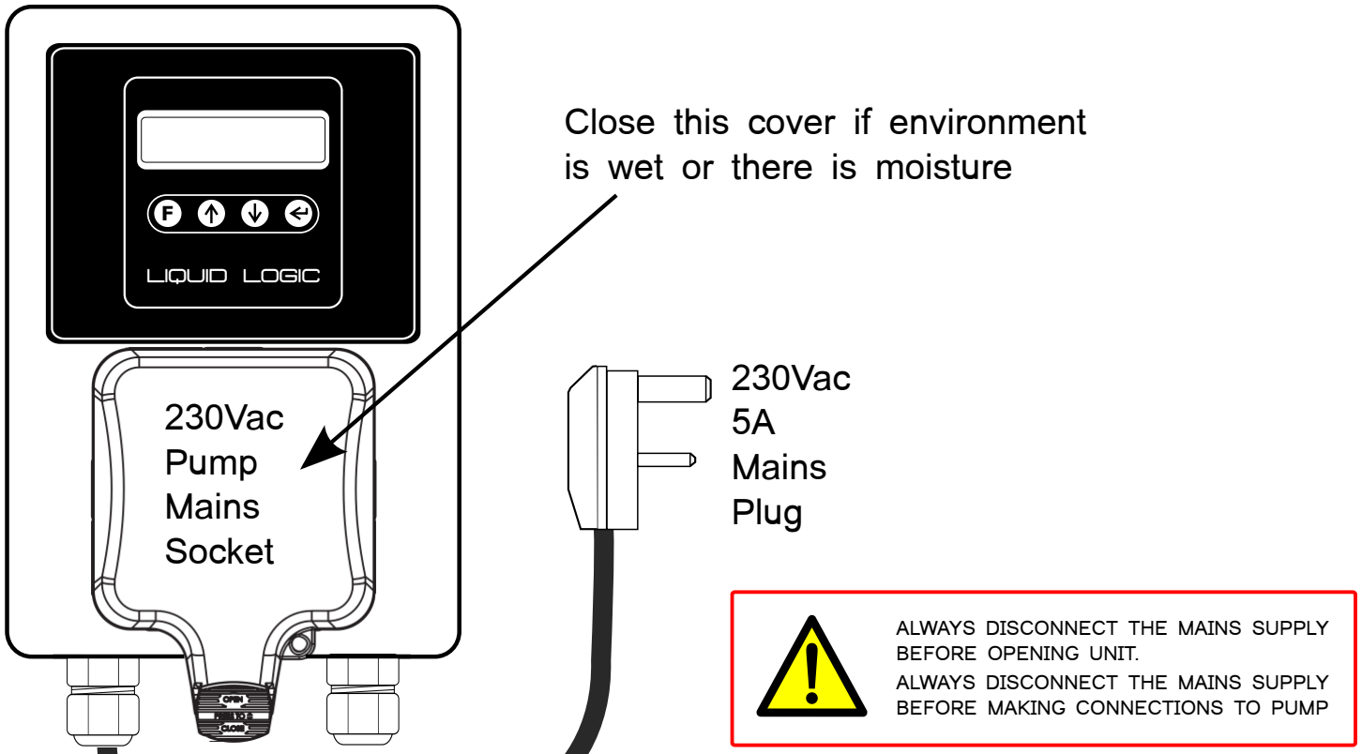
[picture p9: figure]
ALWAYS DISCONNECT THE MAINS SUPPLY BEFORE OPENING UNIT.; Close this cover if environment is wet or there is moisture; 230Vac 5A Mains Plug; 230Vac Pump Mains Socket; LIQUID LOGIC

4

ALWAYS DISCONNECT THE MAINS SUPPLY ! BEFORE MAKING CONNECTIONS TO PUMP

Connect the pump controller following this diagram and the Fitting Instructions.

# Wiring Diagram

# Step 1. Fitting Instructions

This S3 unit is supplied already wired. There is no need to disconnect any wires. Follow these instructions carefully and refer to the wiring diagram.

IT IS RECOMMENDED THAT YOUR S3 IS FITTED AGAINST A WALL OR SIMILAR VERTICAL SURFACE.
1. Ensure the S3 is NOT PLUGGED into the MAINS SUPPLY.
2. Remove the top cover by loosening the four corner screws.
3. Carefully remove the top cover, folding to the right.
4. Screw unit to the wall or vertical surface through the four ready drilled holes in the corners of the back box.
5. Carefully replace the top cover and tighten the four corner screws.
You are now ready to control your pump.
NOTE: Only switch on MAINS SUPPLY to the 230Vac 5A Mains Plug once front cover has been refitted.

DISCLAIMER
Unit must be installed by a competent electrician or electrical engineer. Failure to comply with these instructions could invalidate your warranty.
