eSpark-Backup/oliverstanton-watermonitor/Documents/Client-Files/S3 User Instructions/@6 S3 Quick Start - Use and Warning Messages V1.0.pdf

TDS RO | 30
TDS DI | 1
S3 Pump Controller | Quick Start Guide - Use | S3

### Use

TDS RO | 30
TDS DI | 1

Press enter to display the current TDS purity after the RO and after the DI.

Press enter again to display:
Pressure of mains water in PSI. Temperature of water to hose (degrees C).

Total 12.3KL
Overall 200.5KL

Press enter again to display:
Total water used since last pre-filter
change and zeroing of counter.
Overall is the amount of water used since install.

Pressure 44 PSI
Temperature 18 C

Press enter again to go back to TDS values

6

The S3 controller has a number of warning message for when something goes wrong in your system, these are designed to help in any trouble shooting.

### Warning Messages

WARNING

The following message during a fill
suggests that the mains water has been disconnected (pressure below 10 PSI)

Mains Discnnectd

The following message indicates that the pressure sensor has been disconnected or has failed.
WARNING
Pressure Error

The pressure has dropped below the value set in Pressure Threshold, indicating a blocked carbon or sediment filter.

WARNING | WARNING

The following message is displayed when the amount of water that has flowed goes over the Total Flow Threshold. Check the RO membrane.

Chk RO Membrane | Carbon Filter
