eSpark-Backup/oliverstanton-watermonitor/Documents/Client-Files/S3 User Instructions/@7 S3 TDS V1.0 2.pdf

!

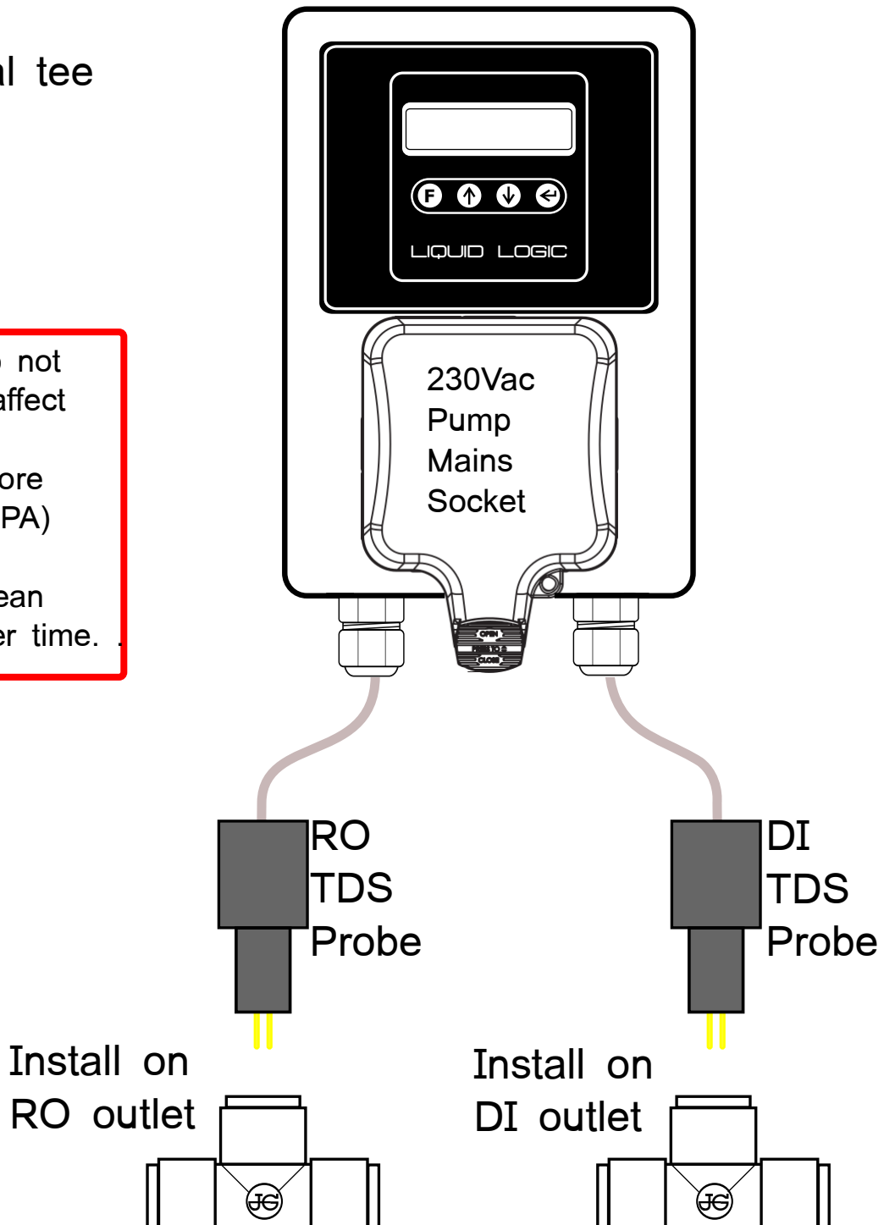
[picture p10: figure]
Install on RO outlet; Install on DI outlet; RO TDS Probe; DI TDS Probe; 230Vac Pump Mains Socket; LIQUID LOGIC

Take care when handling TDS probes. Do not damage gold plated contacts as this will affect TDS accuracy.
Ensure gold plated contacts are clean before use. Clean with ISOPROPANOL alcohol (IPA) and a soft cloth.
Dirty contacts will affect TDS accuracy, clean with IPA if readings appear to deviate over time. .

Fit the TDS probes in John Guest 1/2" equal tee (not supplied) as shown on the diagram.

### Additional Wiring

The TDS function provides an indication of the water purity. The TDS values displayed are in ppm (impurities in parts per million). The TDS meter is intended to check pure water and has a max reading of 50ppm.

### Set Up - TDS (Total Dissolved Solids)

To monitor the current TDS reading press enter repeatedly until it displays the TDS screen.

S3 Pump Controller | TDS | S3

We recommend RO TDS probe be fitted after the RO (reverse osmosis) filter. You can then check the RO is working correctly. If you see these values rising over time it could indicate a problem with your RO
We recommend DI TDS probe be fitted after the DI (de-ionising) vessels. You can then check DI vessels are working (and that resin is not depleted).
For good cleaning a TDS of value below 5ppm after the DI is recommended.
TDS RO | 30
TDS DI | 1
7
