eSpark-Backup/oliverstanton-watermonitor/Documents/Client-Files/S3 User Instructions/@8 S3 Settings 1 Menu V1.0.pdf

S3 Pump Controller | Settings 1 | S3

### Settings Menu

The settings menu allows you to change all of the settings that configure your Static RO system.
The controller can monitor a pressure sensor. If placed after the carbon/sediment filters this gives an indication of when the filters need changing. However the 'Pressure Threshold' must be set when the filters are new/replaced as explained in this manual.

PRESS AND HOLD ENTER
TO EXIT SETTINGS MENU | 8

Pressure Thesh

Press down and enter together to go into the Settings menu.
Press up/down to scroll through the Settings menu until you reach the menu item 'Pressure Threshold'. Press enter to change the Pressure Theshold.

Pressure Thresh
Cal

Use up/down to change.
'Off' Disables pressure sensor warnings 'Cal' calibrates for a new filter, press enter to start calibration. Note: you can adjust this value manually with up/down. Press enter again to go back to the settings menu. (Min value is 30 PSI)
Tot Flow Thresh | Tot Flow Thresh 600KL

Use up/down to set the total water use which will give a warning when reached. Then press enter again to go back
to the settings menu.

Press up to display the next settings menu item, 'Total Flow Threshold'. This sets the water life warning for the RO. Press enter to set this value. eg. 600KL

Enter to set

Enter to set

+ | ,

,
,

Press up to display the next settings menu item, 'TDS RO Limit'. TDS readings over this value from the RO will stop filling. Press enter to change the 'TDS RO Limit'.

TDS RO Limit
Enter to set
| Use up/down to set. 'Off' disables TDS control. Set from 1-50 TDS. Then press enter again to go back to the settings menu.

TDS RO Limit

,

,

Press up to display the next settings menu item, 'TDS DI Limit'. TDS readings over this value from the DI will stop filling. Press enter to change the 'TDS DI Limit'.

TDS DI Limit
Enter to set

Use up/down to set.
'Off' disables TDS control.
Set from 1-10 TDS. Then press enter again to go back to the settings menu.

TDS DI Limit

,

,

30

5
