eSpark-Backup/oliverstanton-watermonitor/Documents/Client-Files/V3 User Instructions/@12 V3 Frost Timed V1.1.pdf

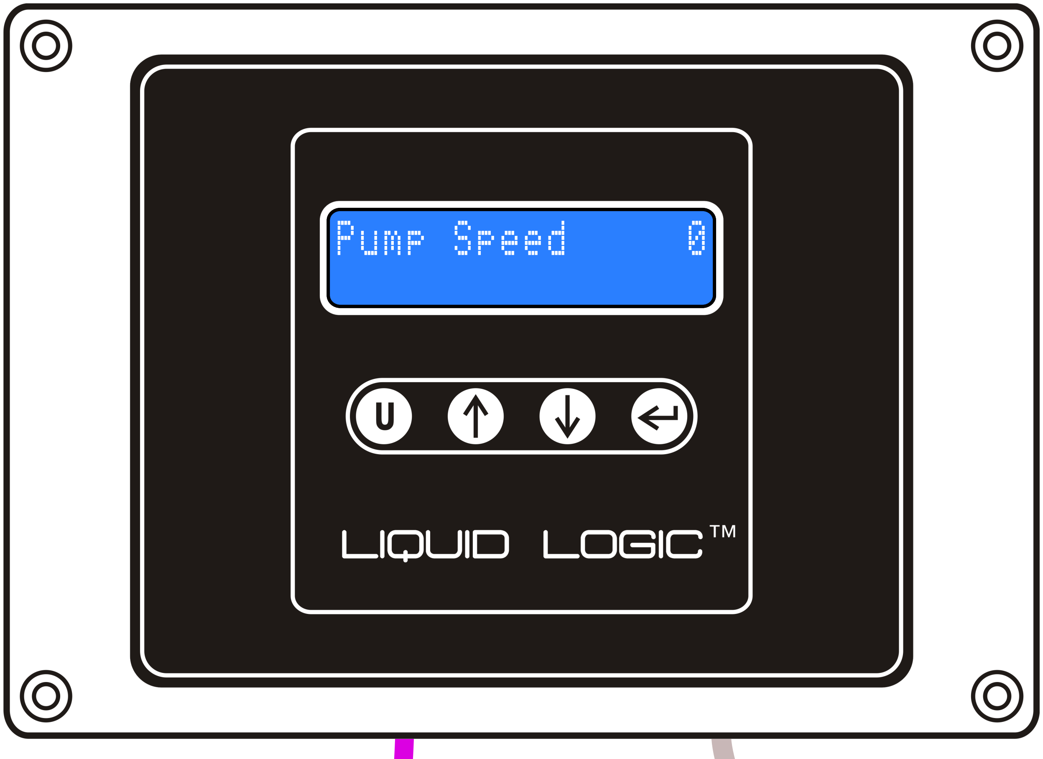
[picture p15: figure]
Pump Speed

To heater

### Additional Wiring

Connect the probe and heater control output as shown.

Note: Frost protection is only active while the unit is off. Ensure the unit is turned off before leaving over night to allow frost protection to work.

Install on
tank outlet

JG

tP Temp
Probe
V3 Pump Controller | Frost Stat | V3

VIOLET

To monitor water temperature (in degrees centigrade) press enter repeatedly until it displays the temperature probe (tp) temperature in degrees centrigrade.

Pressure 44 PSI
Temperature 18 C

When the unit is powered off and the temperature of the water falls below the frost threshold (adjustable 0-5 degrees C, see Settings for details) and frost protection is enabled, the pump and heater are turned on for 10 minutes. The controller will display the 'frost protection' message whilst activated.

This cycle is repeated every time the water reaches the frost threshold.
Dead end and battery low protection are constantly monitoring while in frost mode to protect your system.

WARNING
Frost Protection

Frost Protection is a way of stopping your system from freezing. If you have a heater system fitted (such as a Webasto based hot box) the controller will prevent freezing by turning the heater system on. The controller will also turn on the delivery pump.
The hose must be connected back into the tank to allow the warm water to re-circulate.
In this way a system can be kept warm and frost free even when temperatures drop to below freezing.

12
