eSpark-Backup/oliverstanton-watermonitor/Documents/Client-Files/V3 User Instructions/@13 V3 Settings 1 Menu V1.0.pdf

V3 Pump Controller | Settings 1 | V3

### Settings Menu

Heater

To enter the settings menu press and hold down and enter, until you see this display. Press enter to change the heater setting.

Heater
On

Use up/down to turn heater on/off. Then press enter again to go back to the settings menu.

Frost | Frost On

Use up/down to turn Frost Protection on/off. Then press enter again to go back to the settings menu.

Press up to display the next settings menu item, 'Frost'. This either enables or disables the Frost Protection function. Press enter to change the frost setting

Enter to set

The settings menu allows you to change all of the settings not associated with pump control, such as turning the heater on or off or disabling battery shutdown.

Enter to set

+ | ,

,
,

Press up to display the next settings menu item, 'Frost Threshold'. This sets the temp at which Frost Protection starts. Press enter to change the Frost Theshold.

Frost Theshold
Enter to set
| Use up/down to set the low temp at which frost protection turns on (0 - 5 degrees C). Then press enter again to go back to the settings menu.

Frost Threshold

,

,

Press up to display the next settings menu item, 'Frost Pump'. This sets the rate at which the pump runs in Frost Protection. Press enter to change this item.

Frost Pump
Enter to set

Use up/down to set the pump speed
(0 - 99) Note: 10 for a Webasto system. Then press enter again to go back to the settings menu.

Frost Pump

,

,

2C

10

The controller can monitor a pressure sensor. If placed after the carbon/sediment filters this gives an indication of when the filters need changing. However the 'Pressure Threshold' must be set when the filters are new/replaced as explained in this manual.
PRESS AND HOLD ENTER
TO EXIT SETTINGS MENU
13
