eSpark-Backup/oliverstanton-watermonitor/Documents/Client-Files/V3 User Instructions/@3 V3 Quick Start - Operator Warnings 1 V1.0.pdf

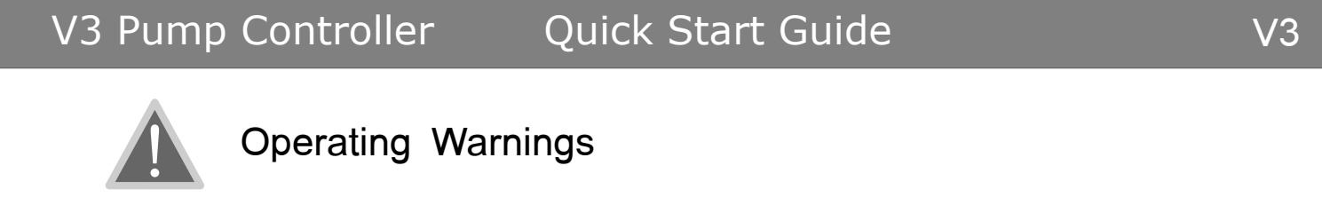
[picture p16: figure]
Operating Warnings; V3 Pump Controller; Quick Start Guide

Adjust your flow settings carefully. Repeated false dead-end detection indicates that the Cal value should be increased (less sensitive).
For absolute safety always wire through the pump pressure switch. However the pressure switch can be bypassed if considered necessary by the end user (the unit will protect itself under normal conditions) but this is not recommended.
This is a WATER PUMP controller: it will not work with air in the system. Always prime your system before starting work. If air in the system causes false dead-end detection, increase 'Dead End' value (less sensitive).
Do not set the 'Dead End' value too high. Setting it higher than necessary places extra strain on both the pump and the controller in a dead end situation. This can result in damage to both the pump and your controller.

* Accuracy of voltmeter depends on length of cable from battery and drive current. A high drive current and long length of cable will decrease the accuracy.

Specification | Value
Supply Voltage Maximum Current Typical Drive Current Voltmeter Accuracy* Enclosure Material Water Resistance Dimensions Working Temperature | 11 - 15 VDC 10A 4-5A +- 200mV ABS IP65 171 x 160 x 60(mm) 0 to 40 C

DISCLAIMER
THE MANUFACTURER RESERVES THE RIGHT TO MAKE CHANGES TO ANY PRODUCT HEREIN TO IMPROVE RELIABILITY, FUNCTION OR DESIGN. THE MANUFACTURER DOES NOT ASSUME ANY LIABILITY ARISING OUT OF THE APPLICATION OR USE OF ANY PRODUCT OR CIRCUIT DESCRIBED HEREIN.

3
