eSpark-Backup/oliverstanton-watermonitor/Documents/Client-Files/V3 User Instructions/@4 V3 Quick Start - Filling V1.0.pdf

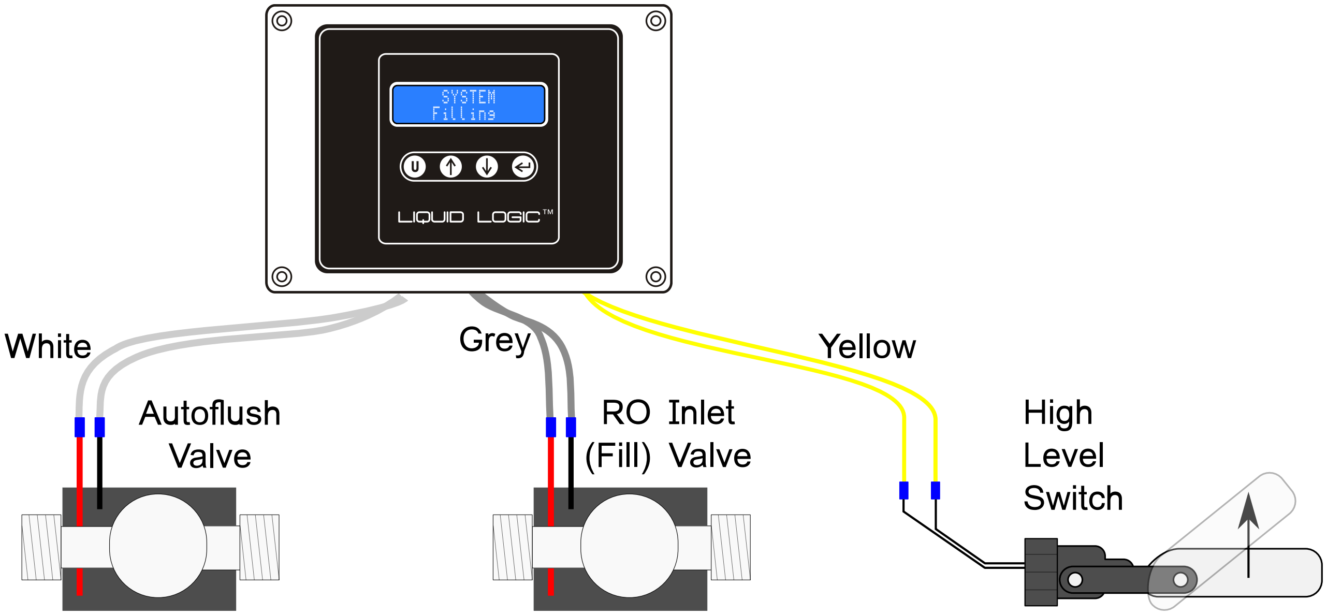
[picture p17: figure]
High Level Switch; Autoflush Valve; RO Inlet (Fill) Valve; White; Grey; Yellow; SYSTEM Filling

Note 1: The solenoid valve will be turned off if the unit detects a dead battery situation (below 10.5V).
Note 2: The tank can be filled when the unit is on and pumping or off.

To manually stop the tank filling, press and briefly hold the up and down buttons again. The display will remove the 'Fill' message.

V3 Pump Controller | Quick Start Guide - Filling | V3

### Step 2. Filling

To start filling the tank simply press and hold the up and down buttons briefly. This will activate the RO inlet solenoid valve, allowing water to fill the tank, until the float switch detects that the tank is full.
Press up and down together to start fill.
System will open Autoflush valve for 5 mins
(in every hour) to clean RO.

SYSTEM
Filling

The Autoflush valve will then close when flushing has finished and controller will continue to fill via the RO Inlet valve.

When the tank water level rises sufficiently to activate the level switch, filling is stopped. All valves are closed.

Connect the pump controller following this diagram. Use only wire from middle gland. NOTE only fit the fuse once all connections are made.

### Step 1. Wiring

SYSTEM
Full

SYSTEM + Fill - Autoflush

+

4
