eSpark-Backup/oliverstanton-watermonitor/Documents/Client-Files/V3 User Instructions/@5 V3 Quick Start - Pumping V1.1.pdf

V3 Pump Controller | Quick Start Guide - Pumping | V3

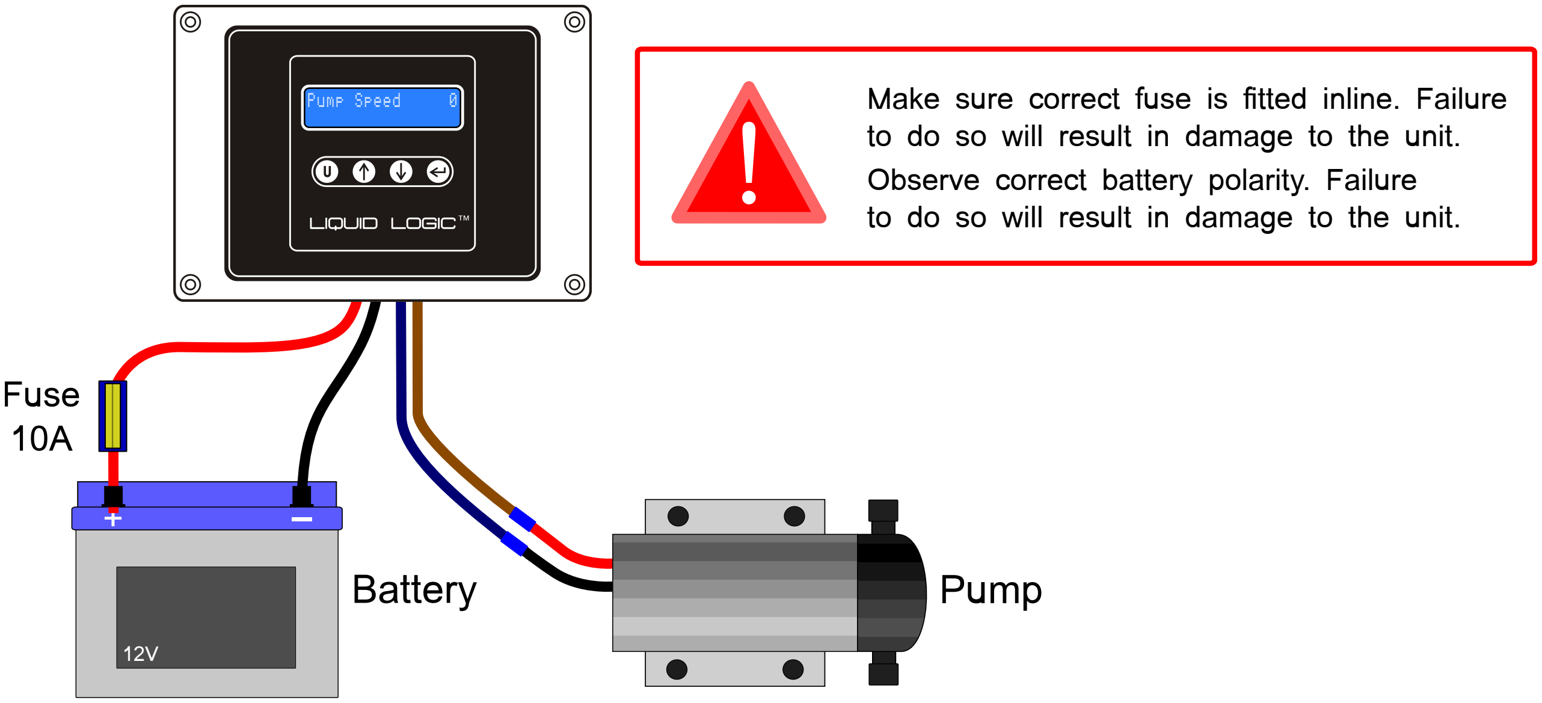
[picture p18: figure]
Observe correct battery polarity. Failure; Fuse 10A; Battery; Pump; Pump Speed

### Step 2. Set Up - AutoCal

Connect your hose and brush to the pump.
Turn on the controller by pressing the user, up or down button. Keep the button held until the display lights up.
Press up until the display shows 50.
Dead End | 0
Enter to save +

Press and hold up and enter to go into 'Dead End' calibration.

Press down to select AutoCal, then enter to start.

After several moments the calculated
Dead End value is shown. Press enter to save.

,

To adjust Dead End value manually follow these steps and use up and down keys.

Connect the pump controller following this diagram. NOTE only fit the fuse once all connections are made.

### Step 1. Wiring

Make sure correct fuse is fitted inline. Failure to do so will result in damage to the unit. to do so will result in damage to the unit.

Pump Speed | 50
Dead End | auto
Enter starts cal

The controller indicates it is calibrating.

Dead End auto
Calibrating...
Dead End | 45
Enter to save

Your controller is ready to deliver water to your pole and you are ready to start
cleaning windows. | 5
