eSpark-Backup/oliverstanton-watermonitor/Documents/Client-Files/V3 User Instructions/@6 V3 Quick Start - Use V1.0.pdf

V3 Pump Controller | Quick Start Guide - Use | V3

,

### Use

Pump Speed 40

Press up or down to set a suitable flow of water.
TDS RO | 30
TDS DI | 1

Press enter to display the current TDS values after the RO and after the DI.

Press enter again to display:
Pressure of mains water in PSI. Temperature of water to hose (degrees C).
Battery | 12.5V | Total | 12.3KL
Overall 200.5KL

Press enter again to display:
Total water used since last pre-filter change and zeroing of counter.
Overall amount of water used since install.

Pressure 44 PSI
Temperature 18 C

Press enter again to go back to pump speed (in percentage 0-99%)

Pump Speed 40

Press enter again to display:
Leisure battery voltage. Above 11V is ok Vehicle voltage. Should increase when engine is running.

Vehicle 13.8V

6
