eSpark-Backup/oliverstanton-watermonitor/Documents/Client-Files/V3 User Instructions/@9 V3 User Settings V1.0.pdf

### Set Up - User Settings, Recall

### Set Up - User Settings, Store

The user settings allow you to quickly change between two different setups. Both flow rate and dead end calibration are saved. This will allow the user to swap between a short and long pole for example.
To save the settings, set the unit pump speed and dead end calibration as normal (see quick start guide). Press and hold the user button ('U').

To apply the saved settings to the pump controller, make sure you are not in any user or dead end calibration or setting menus. For this example we will recall the User2 settings. Press the user button ('U'). The display will show USER.

V3 Pump Controller | User Settings | V3
U | User1

Press and hold the user button ('U').

User2
Enter to save

Press up or down to select 'User1' or 'User2' storage locations e.g. User2

Pump Speed xx

Press enter to save the pump speed and dead end calibration to 'User2' location. Display will return to the pump speed.

Enter to save | 1 | ,
U | User1

Press and release the user button ('U') quickly.
User2
Enter to load

Press up or down to select 'User1' or 'User2' storage locations e.g. User2

Pump Speed xx

Press enter to load the pump speed and dead end calibration from 'User2' location. Display will return to the pump speed.

Enter to load | ,

9
