eSpark-Backup/oliverstanton-watermonitor/Documents/Client-Files/V3 User Instructions/@7 V3 Quick Start - Warning Messages V1.0.pdf

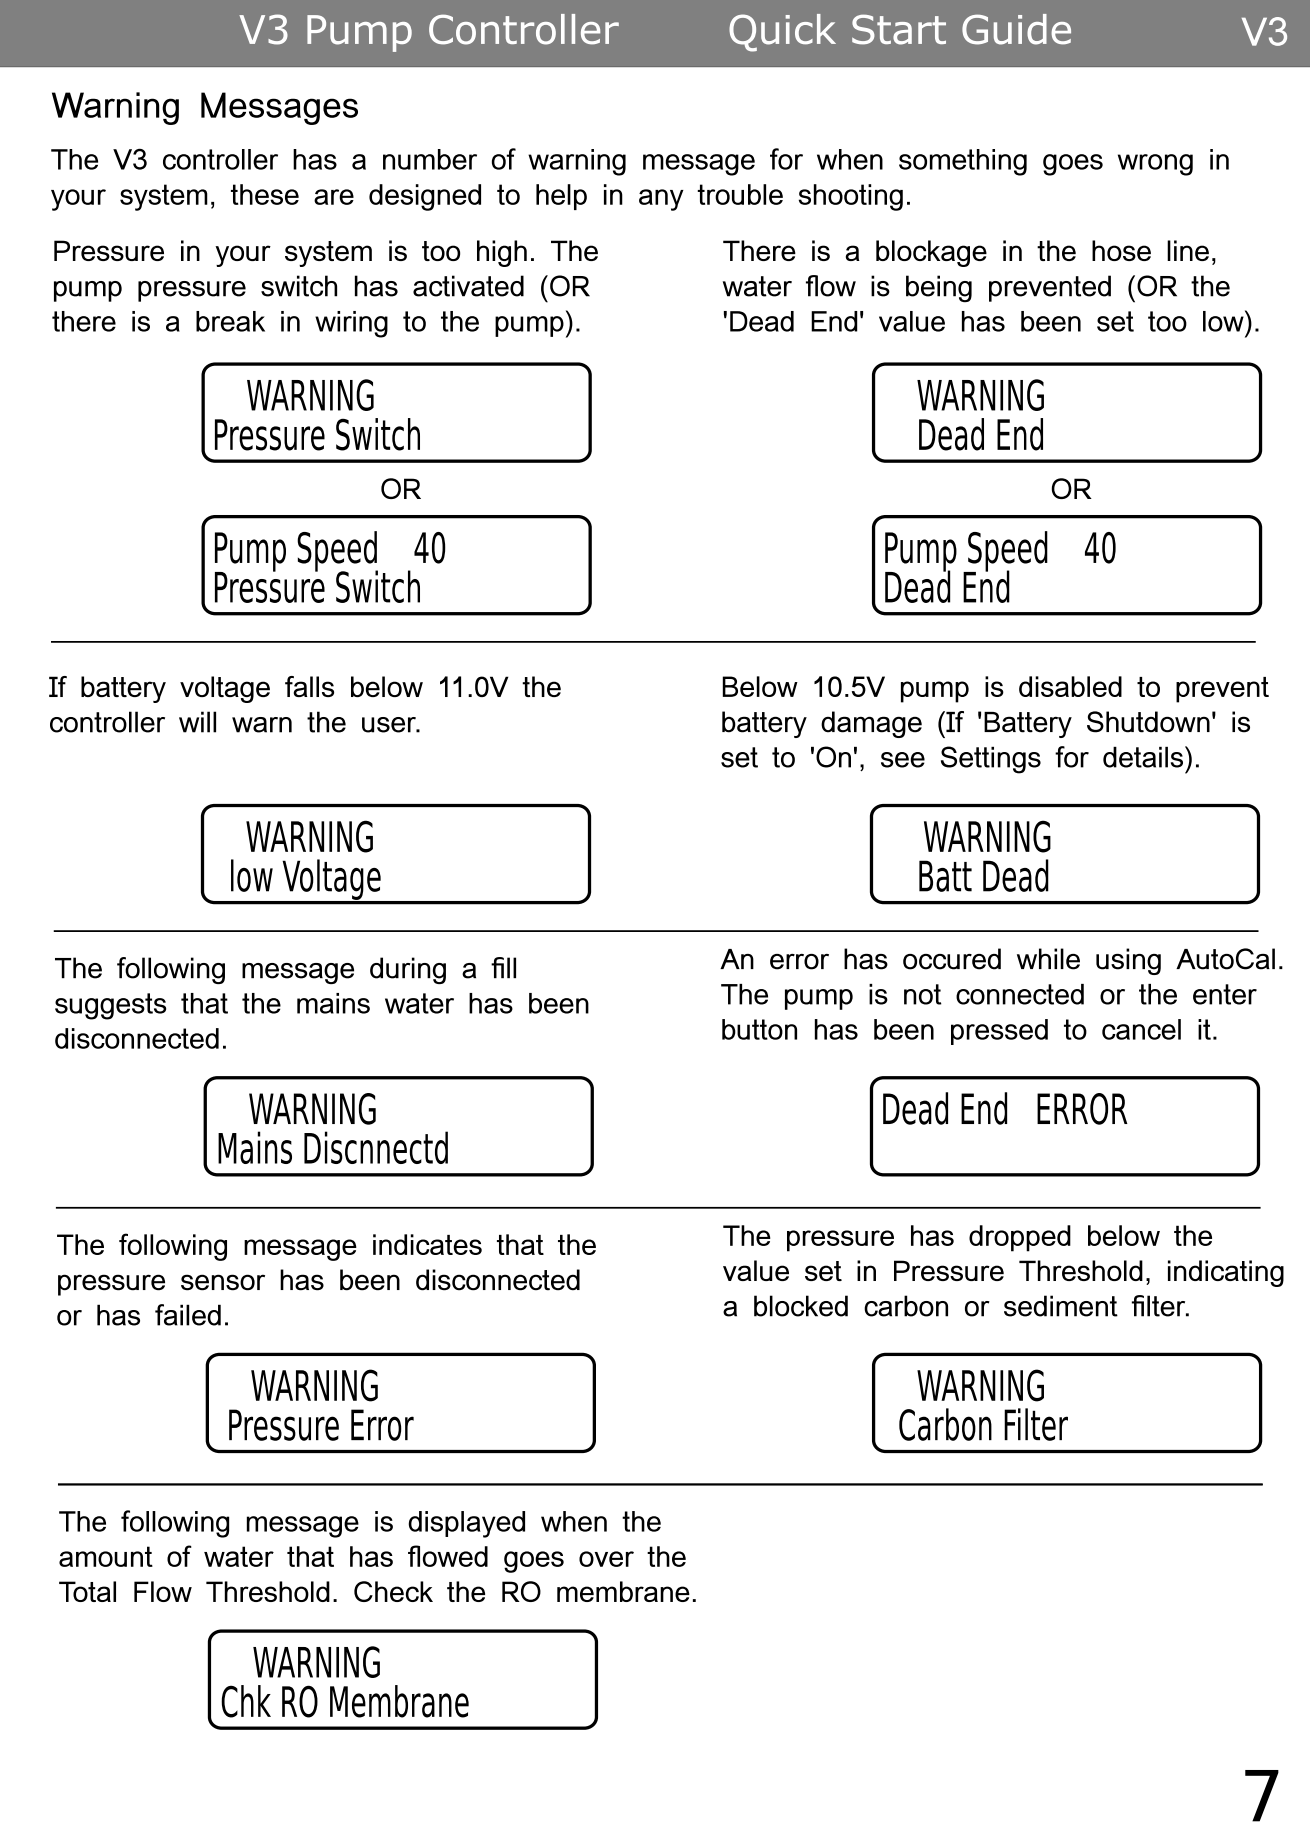
[picture p20: page 1]
