eSpark-Backup/oliverstanton-watermonitor/Documents/Client-Files/@2 V3 v11 Overview - System Diagram V1.0.pdf

## V3 Controller

V3 Pump Controller | Overview | v11

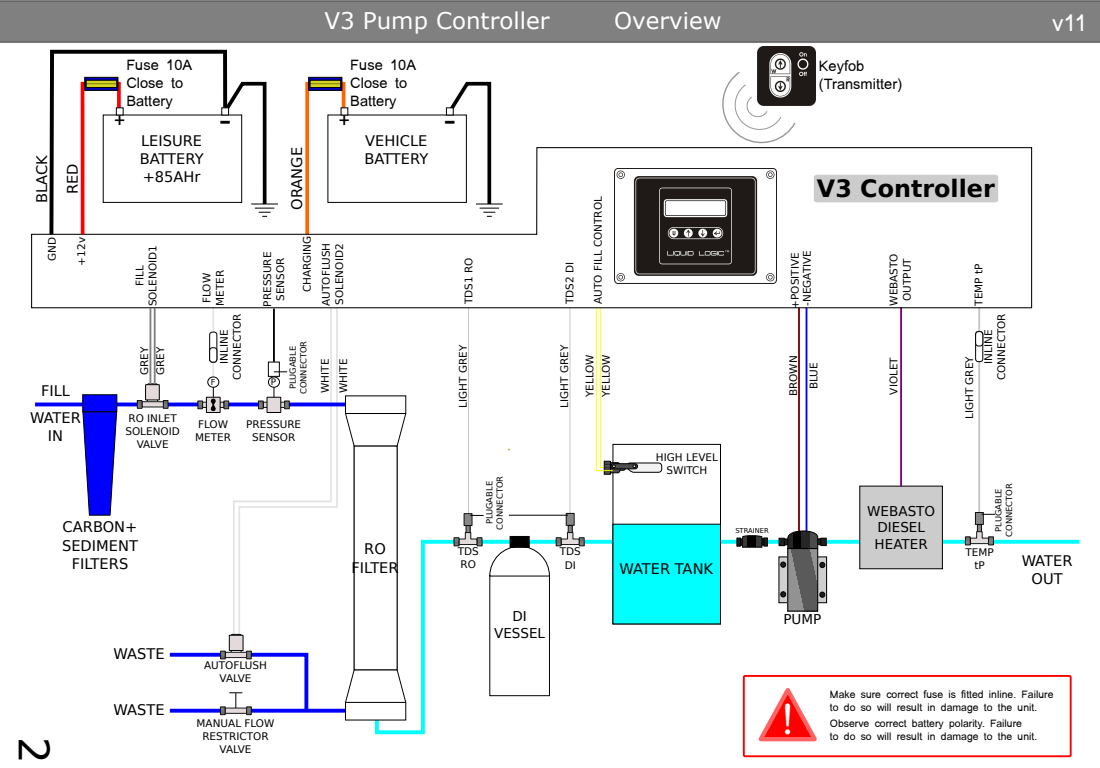
[picture p21: page 1]
WATER TANK; HIGH LEVEL SWITCH; CARBON+ SEDIMENT FILTERS; WASTE; WATER IN; RO INLET SOLENOID VALVE; MANUAL FLOW RESTRICTOR VALVE; TDS1 RO; STRAINER; PUMP; AUTOFLUSH VALVE; FLOW METER; TDS RO; PRESSURE SENSOR; TDS DI; PRESSURE; TDS2 DI; SENSOR; AUTOFLUSH; SOLENOID2; TEMP; tPTEMP tP; WEBASTO DIESEL HEATER; FILL; WATER OUT; SOLENOID1; WEBASTO; FLOW; OUTPUT; METER; +POSITIVE; -NEGATIVE; GREY; INLINE; CONNECTOR; PLUGABLE; WHITE; LIGHT GREY; YELLOW; BROWN; BLUE; VIOLET; - VEHICLE; BATTERY; RED; BLACK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

AUTO FILL CONTROL

Make sure correct fuse is fitted inline. Failure
Observe correct battery polarity. Failure ! to do so will result in damage to the unit.
to do so will result in damage to the unit.
