eSpark-Backup/oliverstanton-watermonitor/Documents/Client-Files/GTV3_Schematic.pdf

### Temperature

1-wire-DS18B20 | Boot Loader | SPI Radio

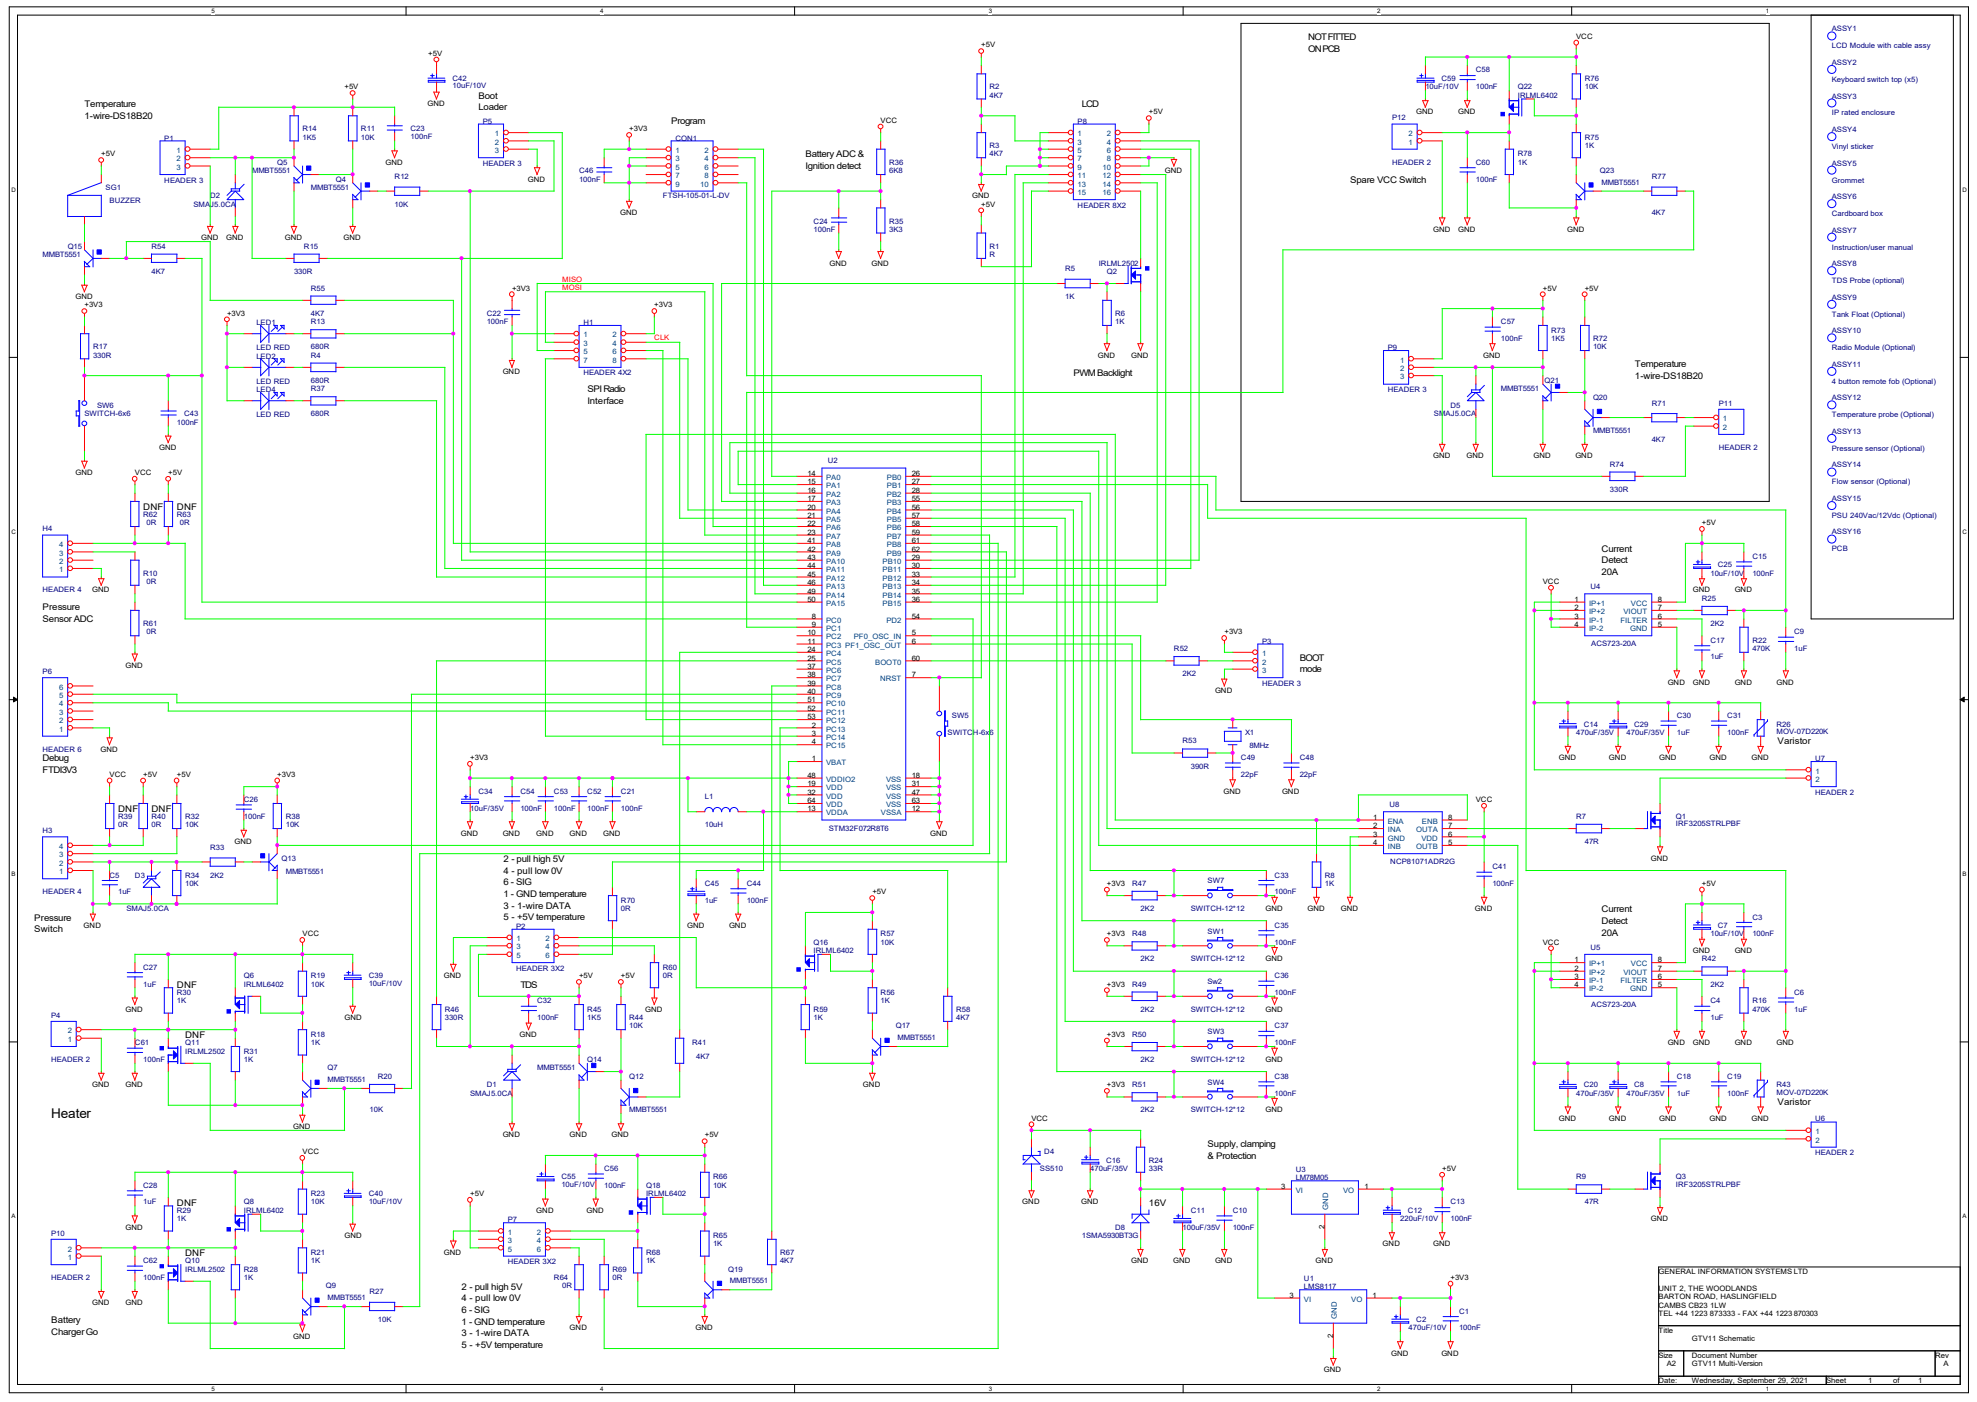
[picture p22: page 1]

NOT FITTED ON PCB | VCC

LCD Module with cable assy ASSY2 Keyboard switch top (x5) ASSY3

GND GND GND GND GND
P12 HEADER 2

IP rated enclosure ASSY4 Vinyl sticker ASSY5 Grommet ASSY6 Cardboard box ASSY7

Instruction/user manual ASSY8 TDS Probe (optional) ASSY9 Tank Float (Optional) ASSY10 Radio Module (Optional) ASSY11

4 button remote fob (Optional) ASSY12 Temperature probe (Optional) ASSY13 Pressure sensor (Optional) ASSY14 Flow sensor (Optional) ASSY15 PSU 240Vac/12Vdc (Optional) ASSY16 PCB

16 | | 28
17 | | 55
20 | | 56
21 | | 57

42 | | 62
43 | | 29
44 | | 30
45 | | 33
46 | | 34

2 - pull high 5V

2 | 2K2 U5ACS723-20A 7
