eSpark-Backup/oliverstanton-watermonitor/Documents/Client-Files/Schematic_GTV11-Platform_Sheet-1_20190105214049.pdf

### VCC

## Battery ADC and

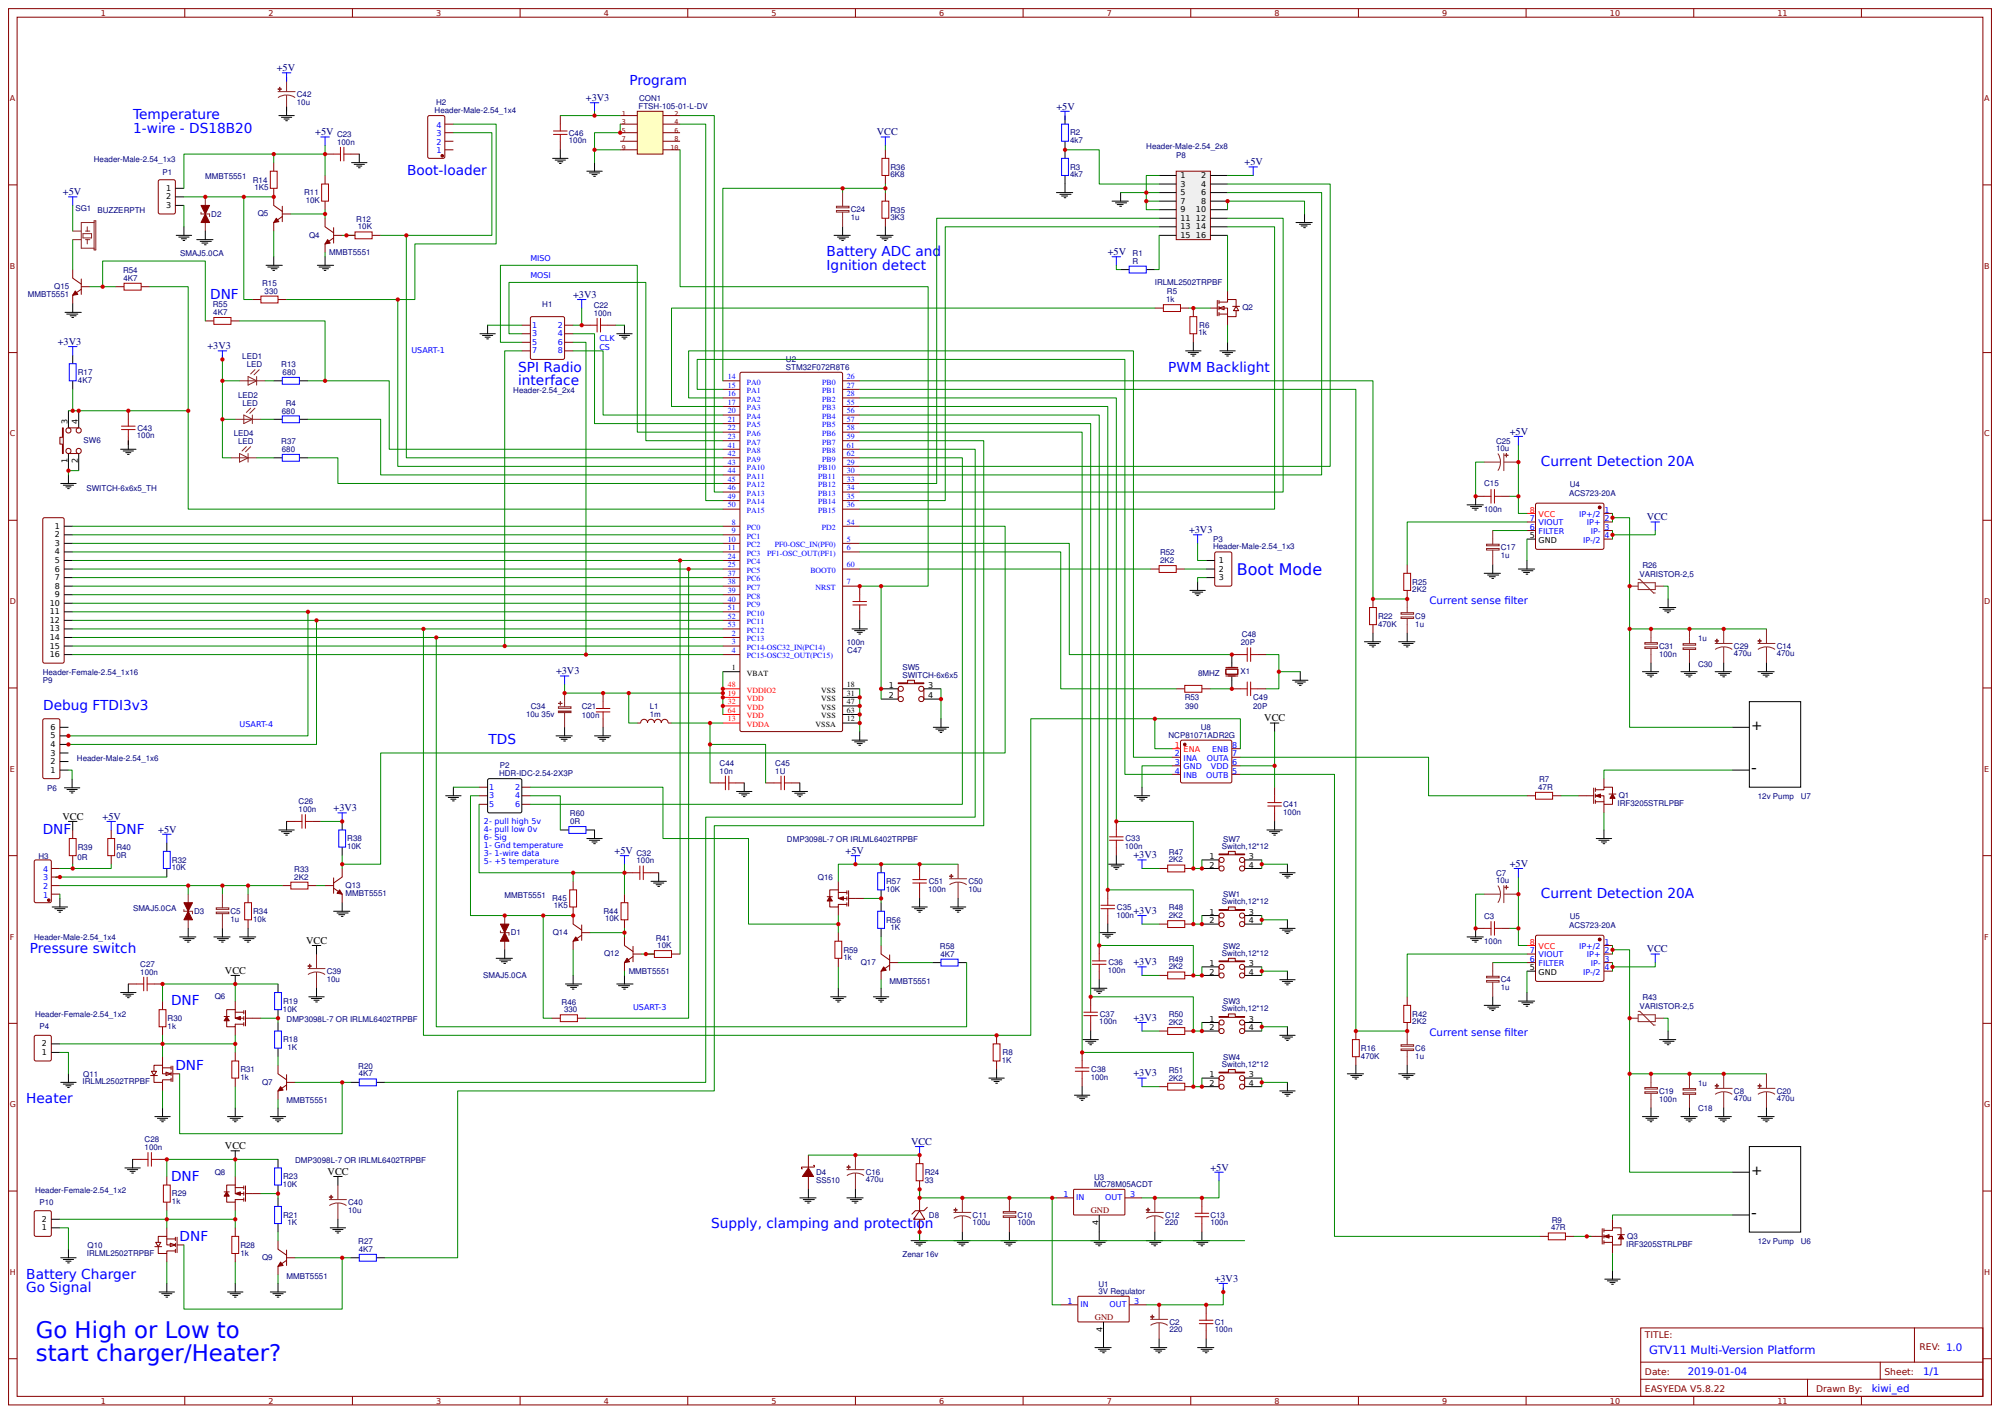
[picture p23: page 1]

IP-/2 4 GND 5 FILTER 6 VIOUT 7 VCC 8

Battery Charger
Go Signal
Go High or Low to
start charger/Heater?
