eSpark-Backup/oliverstanton-watermonitor/Documents/Client-Files/S3 User Instructions/@2 S3 Overview - System Diagram V1.1.pdf

# S3 Controller

S3 Pump Controller | Overview | S3

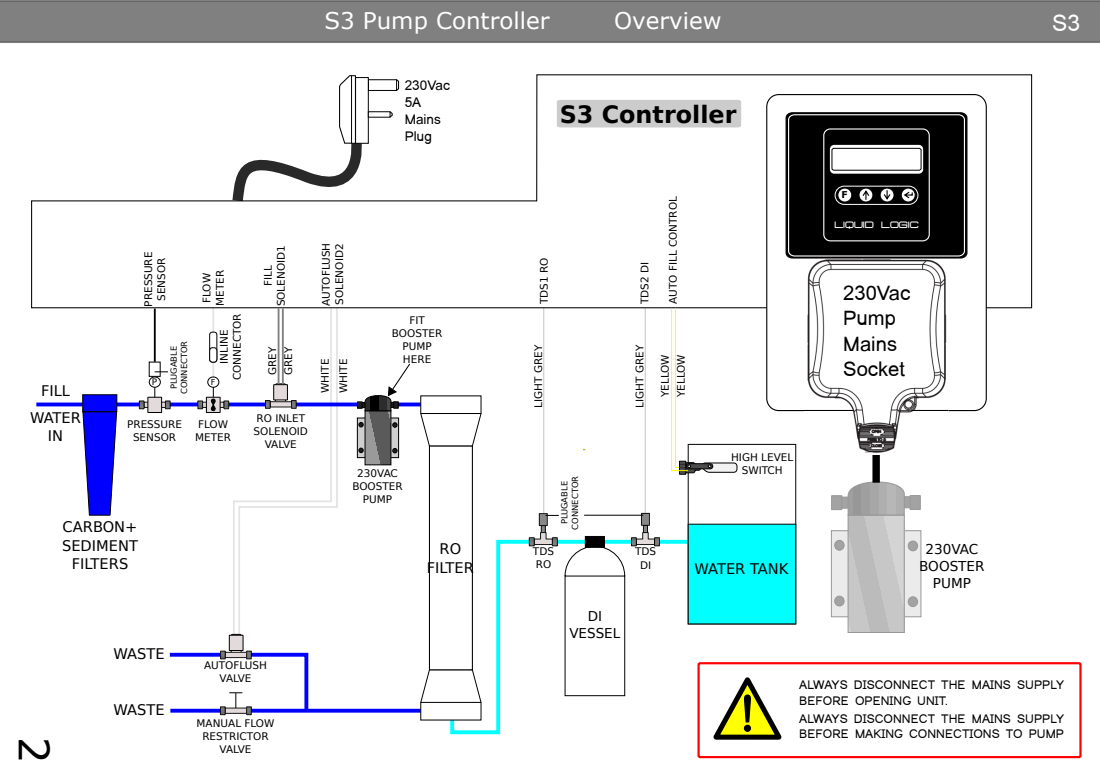
[picture p24: page 1]
WATER TANK; HIGH LEVEL SWITCH; CARBON+ SEDIMENT FILTERS; WASTE; WATER IN; MANUAL FLOW RESTRICTOR VALVE; TDS1 RO; AUTOFLUSH VALVE; FLOW METER; TDS RO; PRESSURE SENSOR; TDS DI; PRESSURE; TDS2 DI; SENSOR; AUTOFLUSH; SOLENOID2; FILL; FLOW; METER; RO INLET SOLENOID; VALVE FILL SOLENOID¹ GREY; GREY; INLINE; CONNECTOR; PLUGABLE; WHITE; LIGHT GREY; YELLOW; RO FILTER; DI VESSEL; 230Vac 5A Mains Plug; 230VAC BOOSTER PUMP; 230Vac Pump Mains Socket; LIQUID LOGIC; FIT BOOSTER PUMP HERE

AUTO FILL CONTROL

ALWAYS DISCONNECT THE MAINS SUPPLY
ALWAYS DISCONNECT THE MAINS SUPPLY ! BEFORE MAKING CONNECTIONS TO PUMP
BEFORE OPENING UNIT.
