eSpark-Backup/oliverstanton-watermonitor/Design-Files/Fob_TransmitterV2.00/Deliverables/Assembly_Drawing/Assembly Drawing.pdf

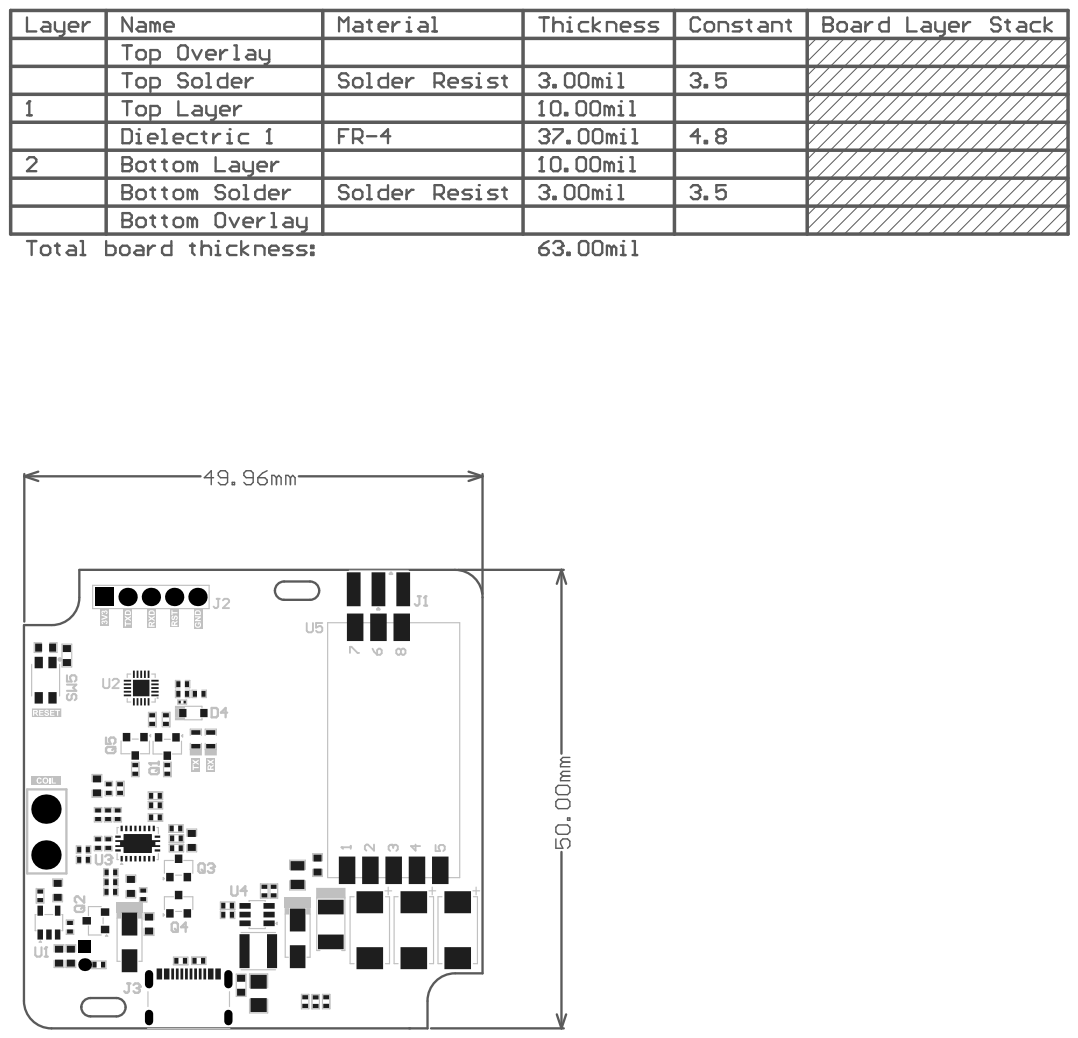
[picture p25: page 1]

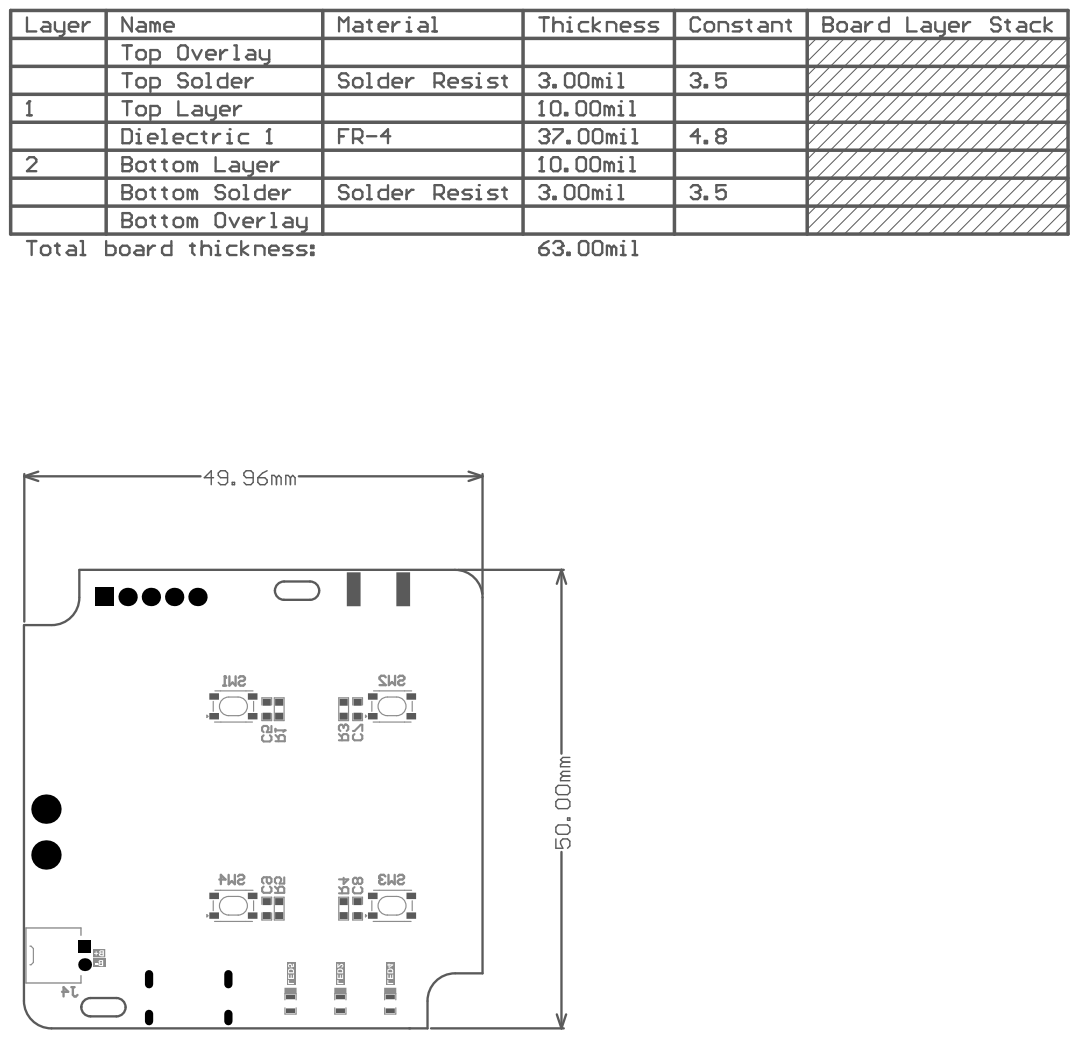
[picture p26: page 2]
