eSpark-Backup/oliverstanton-watermonitor/(list of files, drawings)

Other design files:
Design-Files/Fob_TransmitterV2.00/Top_Sheet.SchDoc
Design-Files/Fob_TransmitterV2.00/Transmitter_Section.SchDoc
Design-Files/GTV3.5_Board/Connector_Section.SchDoc
Design-Files/GTV3.5_Board/Controller_Section.SchDoc
Design-Files/GTV3.5_Board/Current_Sense_Section.SchDoc
Design-Files/GTV3.5_Board/GTV3.5_Board.PrjPcb
Design-Files/GTV3.5_Board/Heater_Section.SchDoc
Design-Files/GTV3.5_Board/HMI_Encoder_NFC_Sheet.SchDoc
Design-Files/GTV3.5_Board/LED_Section.SchDoc
Design-Files/GTV3.5_Board/PCB_GTV3.5.PcbDoc
Design-Files/GTV3.5_Board/Peripheral_Section.SchDoc
Design-Files/GTV3.5_Board/Receiver_Section.SchDoc
Design-Files/GTV3.5_Board/Regulator_Section.SchDoc
Design-Files/GTV3.5_Board/Reverse Protection_Section.SchDoc
Design-Files/GTV3.5_Board/SD-Card-Sheet.SchDoc
Design-Files/GTV3.5_Board/Sensor_Section.SchDoc
Design-Files/GTV3.5_Board/Switch_Sheet.SchDoc
Design-Files/GTV3.5_Board/Temperature_Sense_Section.SchDoc
Design-Files/GTV3.5_Board/Top_Sheet.SchDoc
Design-Files/GTV3.5_Board/Ultra_Sonic_Section.SchDoc
Design-Files/GTV3.5_Board/Valve_Section.SchDoc
Design-Files/GTV3.5_Board/Voltage_Monitoring_Section.SchDoc
Design-Files/GTV3.5_Board/WIFI_Sheet.SchDoc
Design-Files/GTV11-Board/Battery_Charger_Sheet.SchDoc
Design-Files/GTV11-Board/Current_Sense_Sheet.SchDoc
Design-Files/GTV11-Board/Gate_Driver_Sheet.SchDoc
Design-Files/GTV11-Board/Power_Section.SchDoc
Design-Files/GTV11-Board/Regulator_Sheet.SchDoc
Design-Files/TDS_Meter/TDS_Sense_Section.SchDoc
Design-Files/WIFI_BoardV1.00/WIFI_BoardV1.00.PrjPcb
Design-Files/WIFI_BoardV1.00/WiFI_Sheet.SchDoc
Library-Files/V3_Pcblib.PcbLib
Library-Files/V3_Schlib.SchLib
